LEP-PEA-EPUSP/OpenSourcePowerElectronics-HW-LoadBoard-2026/README.md

# OpenSourcePowerElectronics-HW-LoadBoard-2026

This repository contains the manuals, schematics, layouts and other files necessary to build and used the AC and DC load boards.
