LEP-PEA-EPUSP/OpenSourcePowerElectronics-HW-LoadBoard-2026/Schematics and Layout/AC Load/Esquemático.PNG

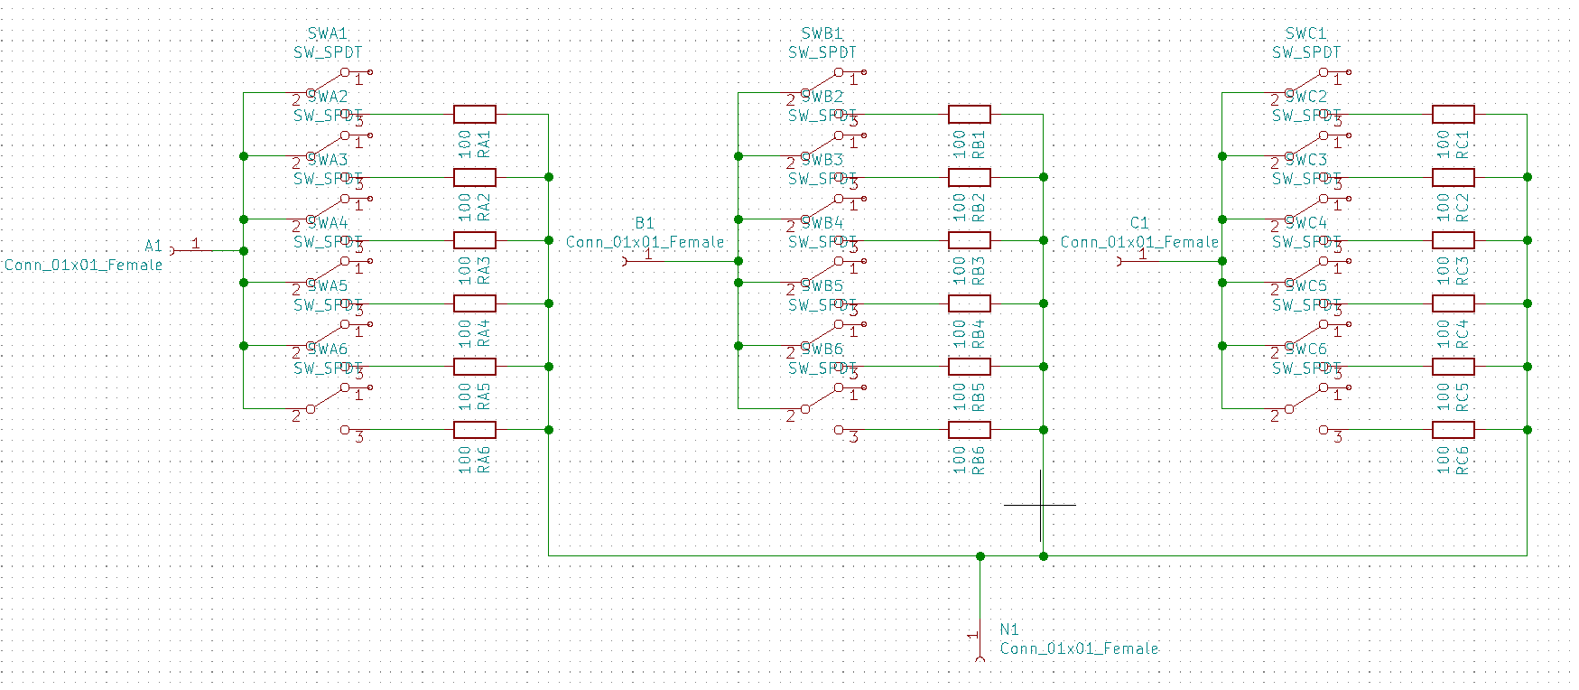
Schematics and Layout/AC Load/Esquemático.PNG
