LEP-PEA-EPUSP/OpenSourcePowerElectronics-HW-LoadBoard-2026/Schematics and Layout/DC Load/Esquemático_CC.PNG

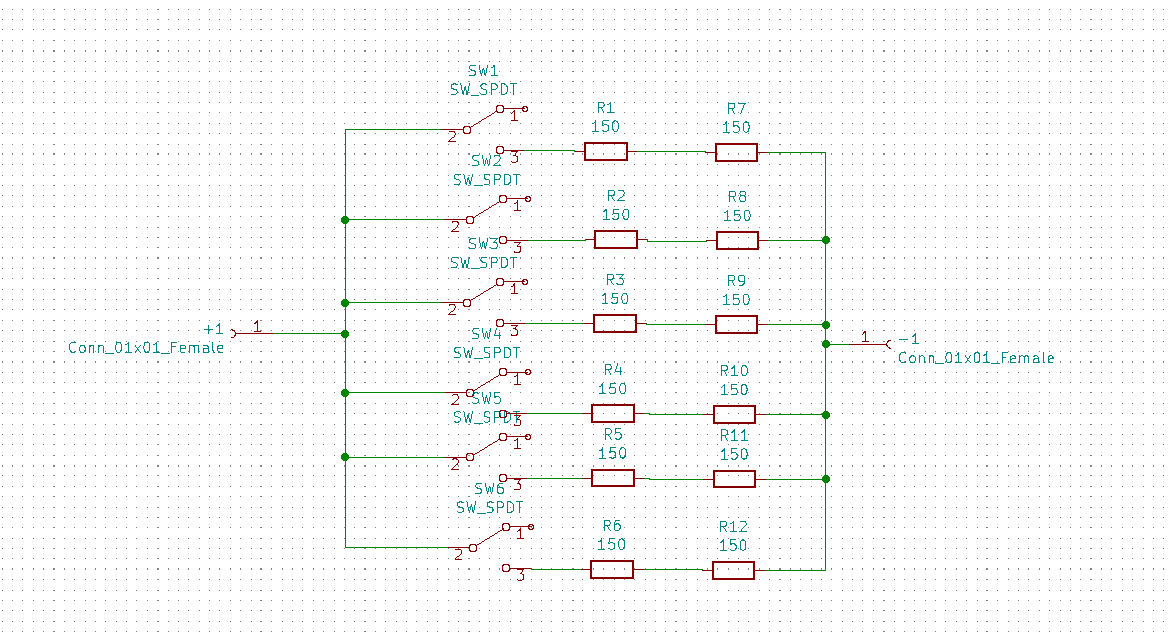
Schematics and Layout/DC Load/Esquemático_CC.PNG
