LEP-PEA-EPUSP/OpenSourcePowerElectronics-HW-LoadBoard-2026/Schematics and Layout/DC Load/Proposta CC.png

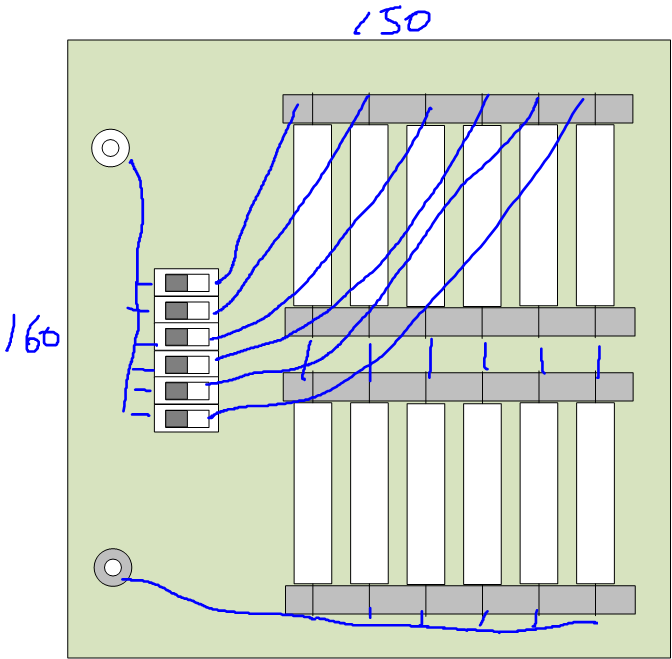
Schematics and Layout/DC Load/Proposta CC.png
