LEP-PEA-EPUSP/OpenSourcePowerElectronics-HW-LoadBoard-2026/Schematics and Layout/AC Load/placa de resistores CAx.pdf

Placa cimenticia:
- espessura: 8mm
- altura proposta da barra: 16mm
- comprimento: a decidir

Resistor de 10W porcelana
- Comp=48mm
- Larg= 9,5mm
- altura=9,5
- terminal : comp=32mm;
diam=0,7mm

Chave HH
- ver detalhes dos terminais
- soldar pinos da carcaça

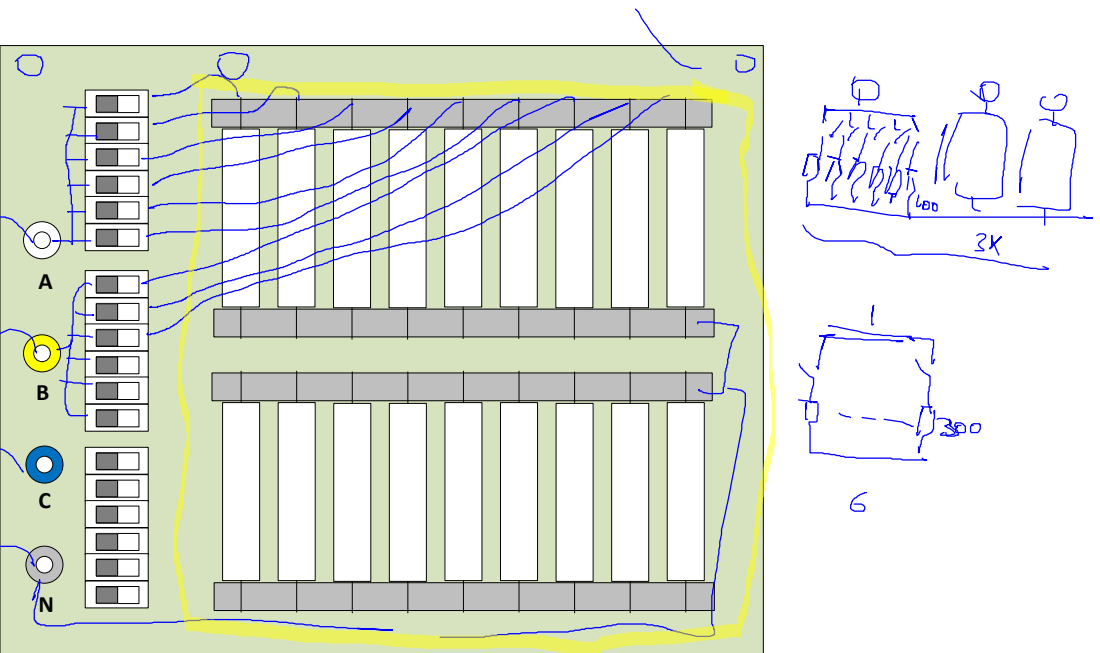
[picture p19: page 2]
ABCN

N | N | N

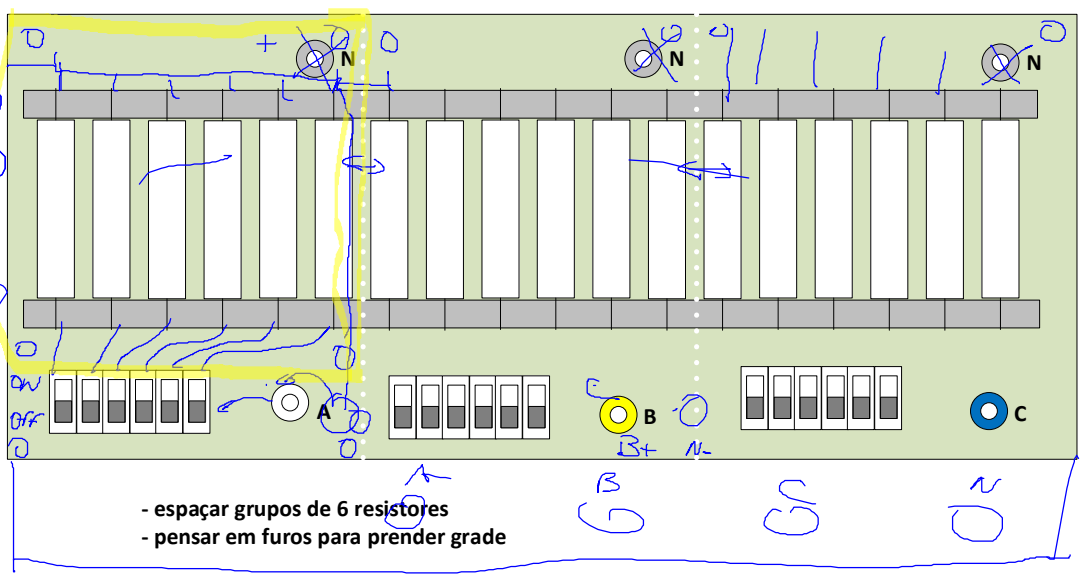
[picture p20: page 3]

- espaçar grupos de 6 resistores
- pensar em furos para prender grade
