LEP-PEA-EPUSP/OpenSourcePowerElectronics-HW-LoadBoard-2026/Schematics and Layout/AC Load/camadas separadas.pdf

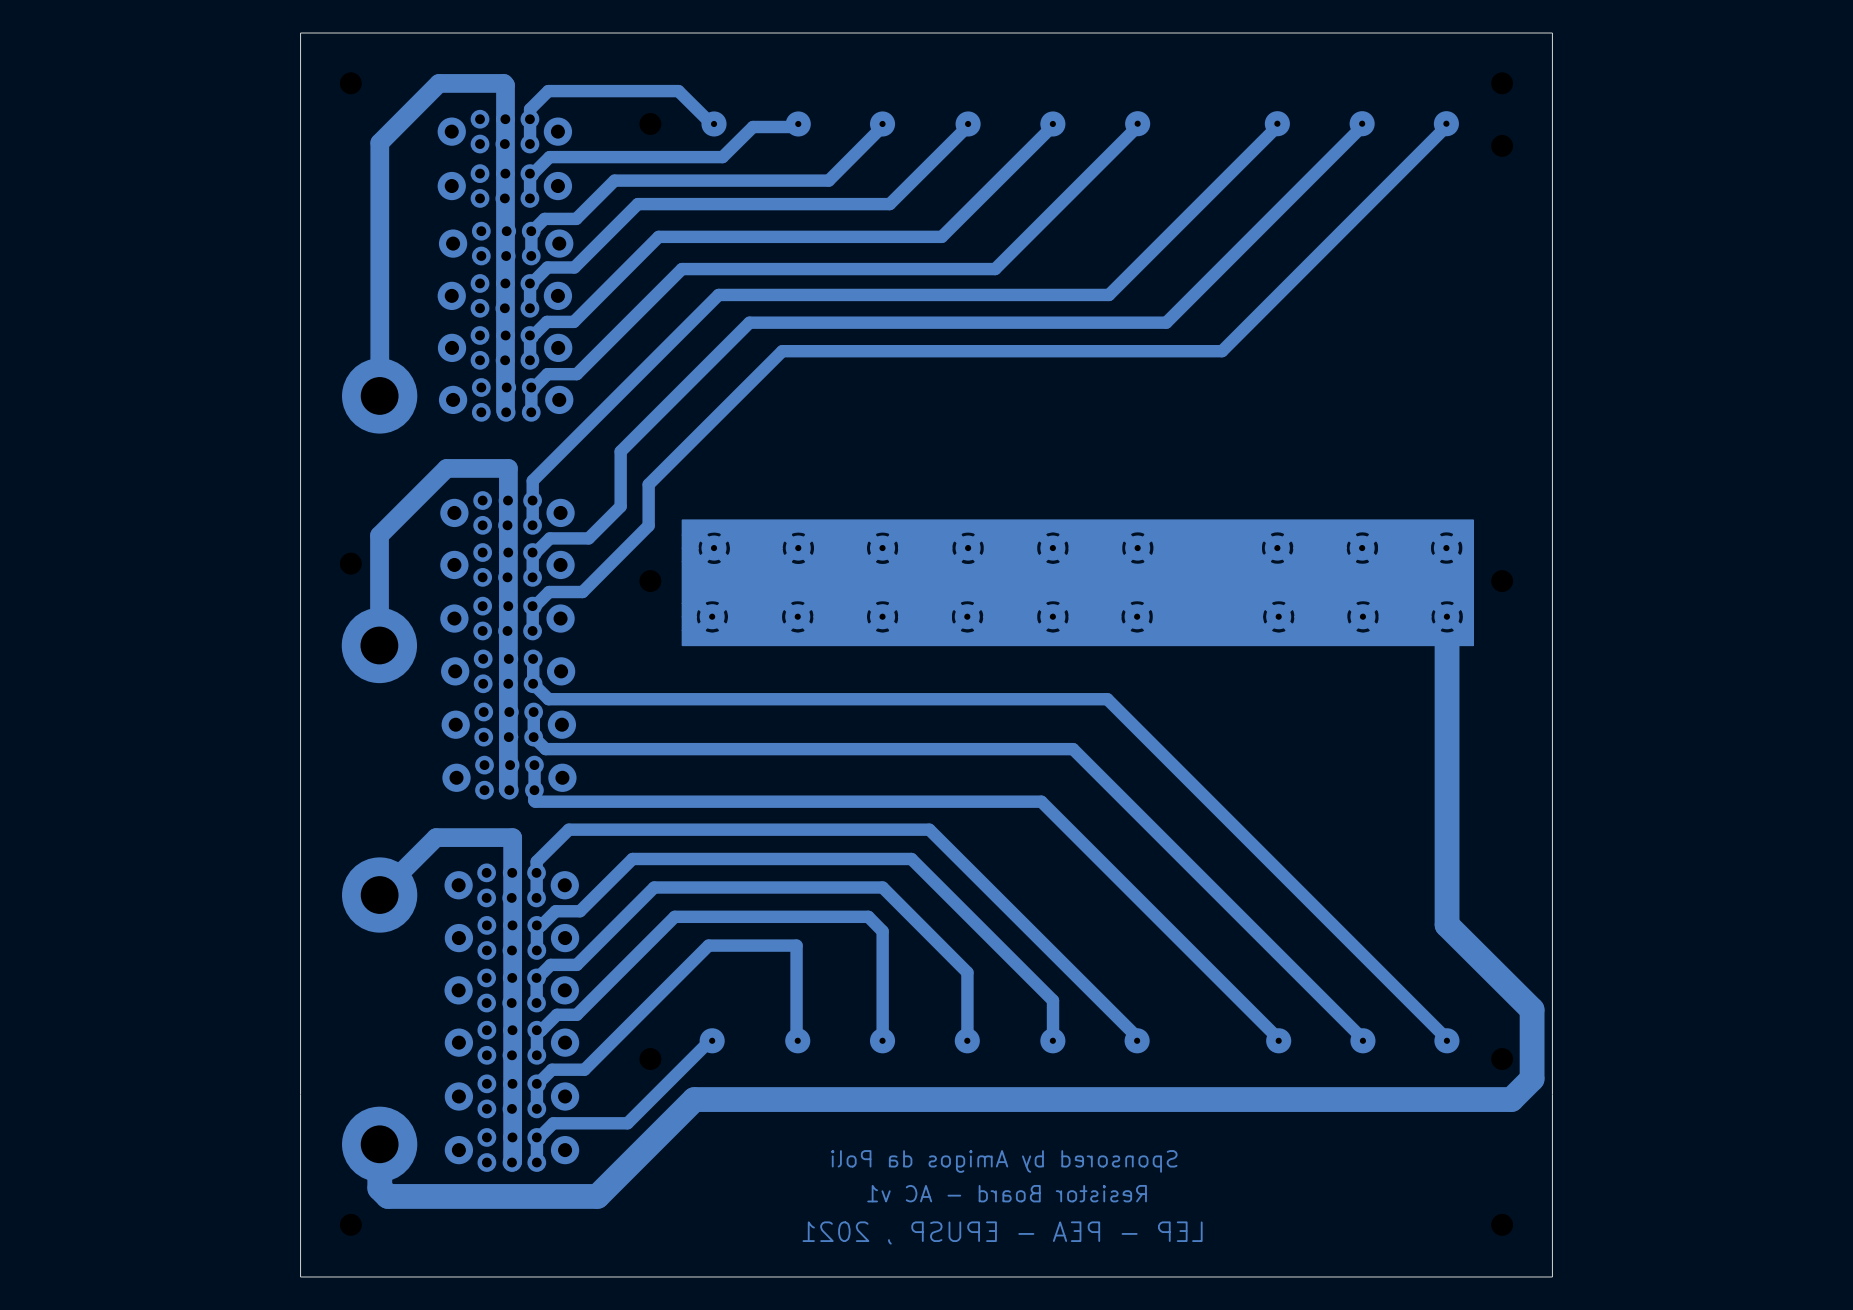
[picture p21: page 1]

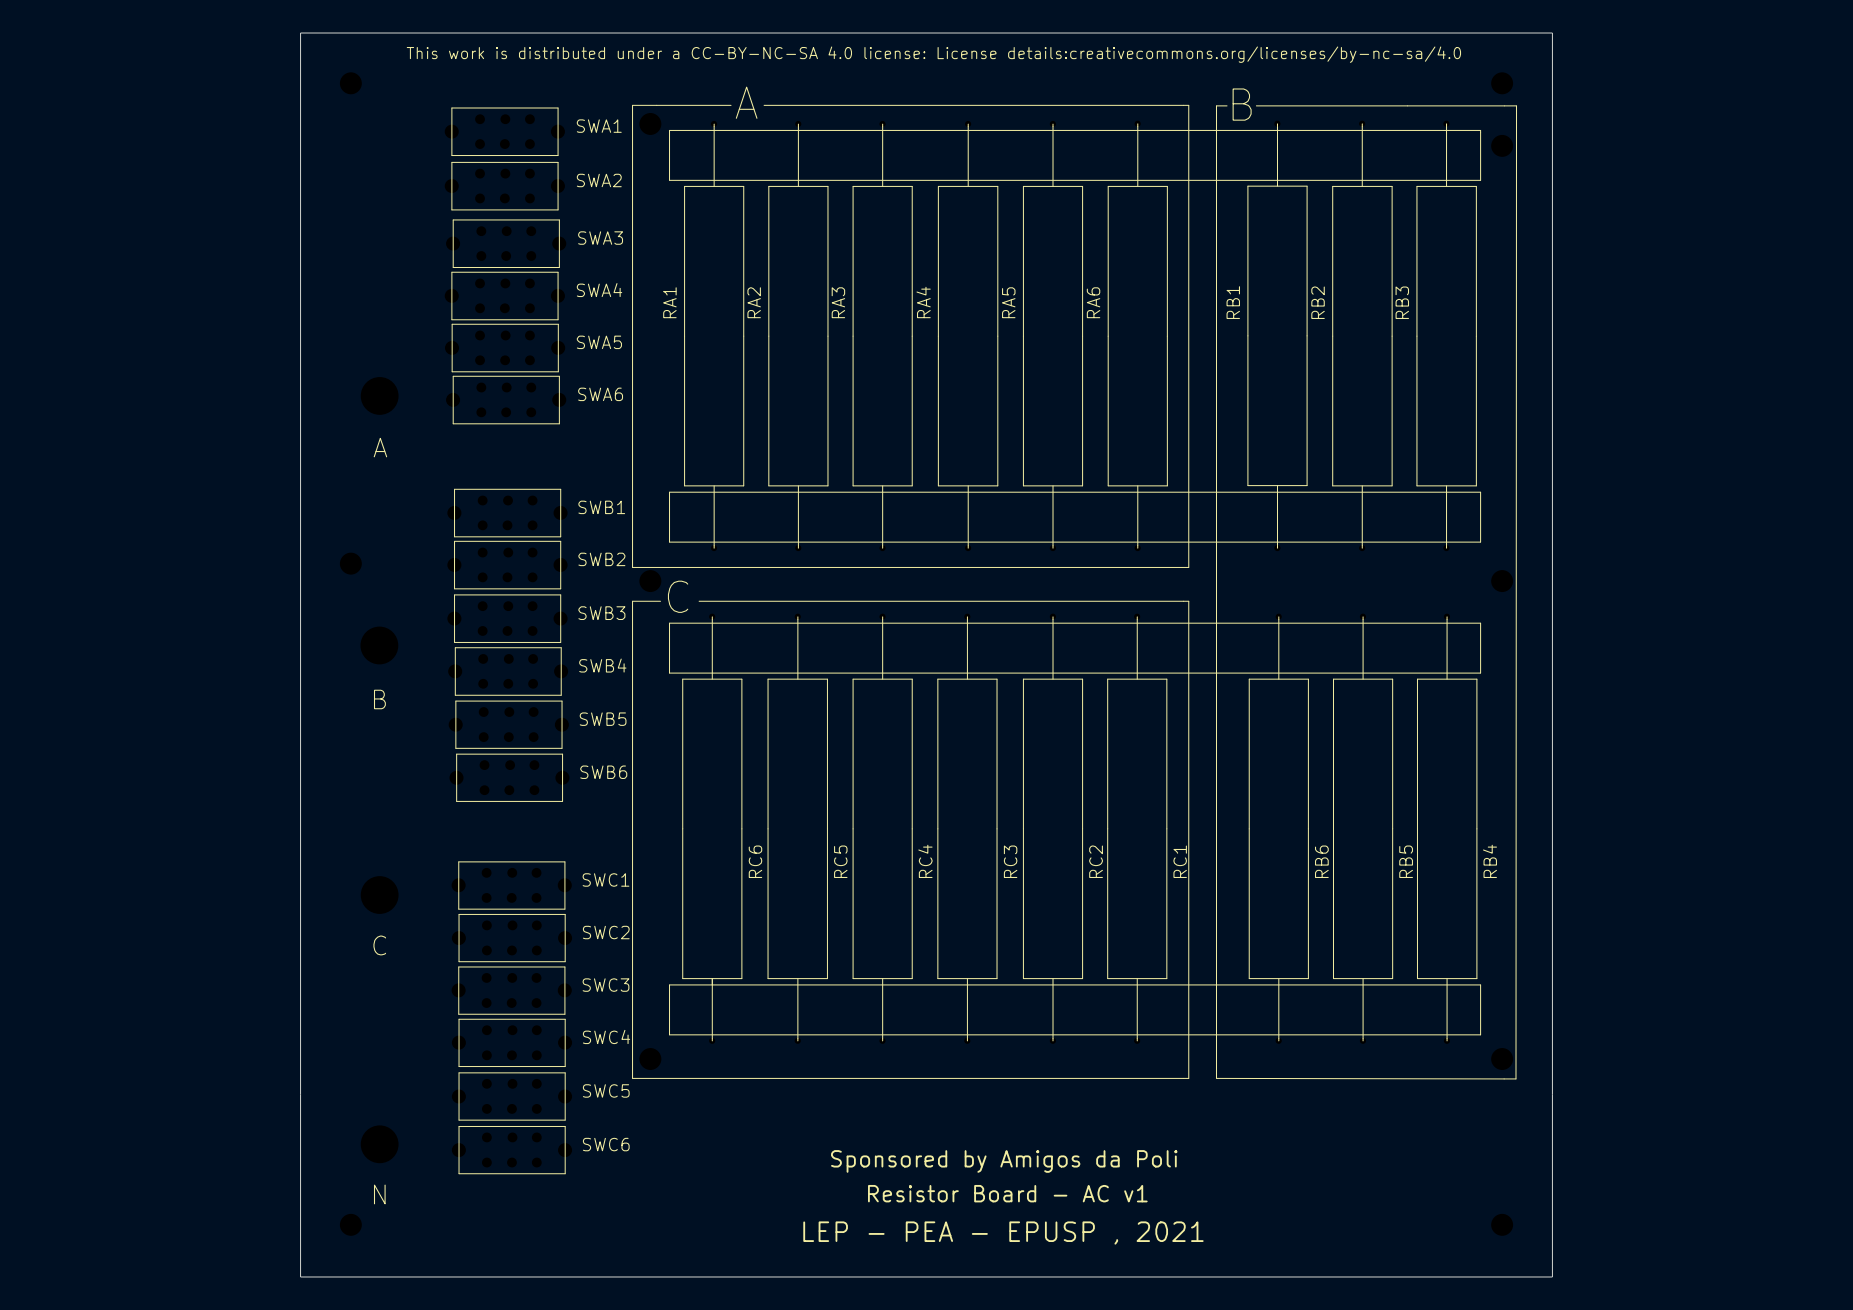
[picture p22: page 2]

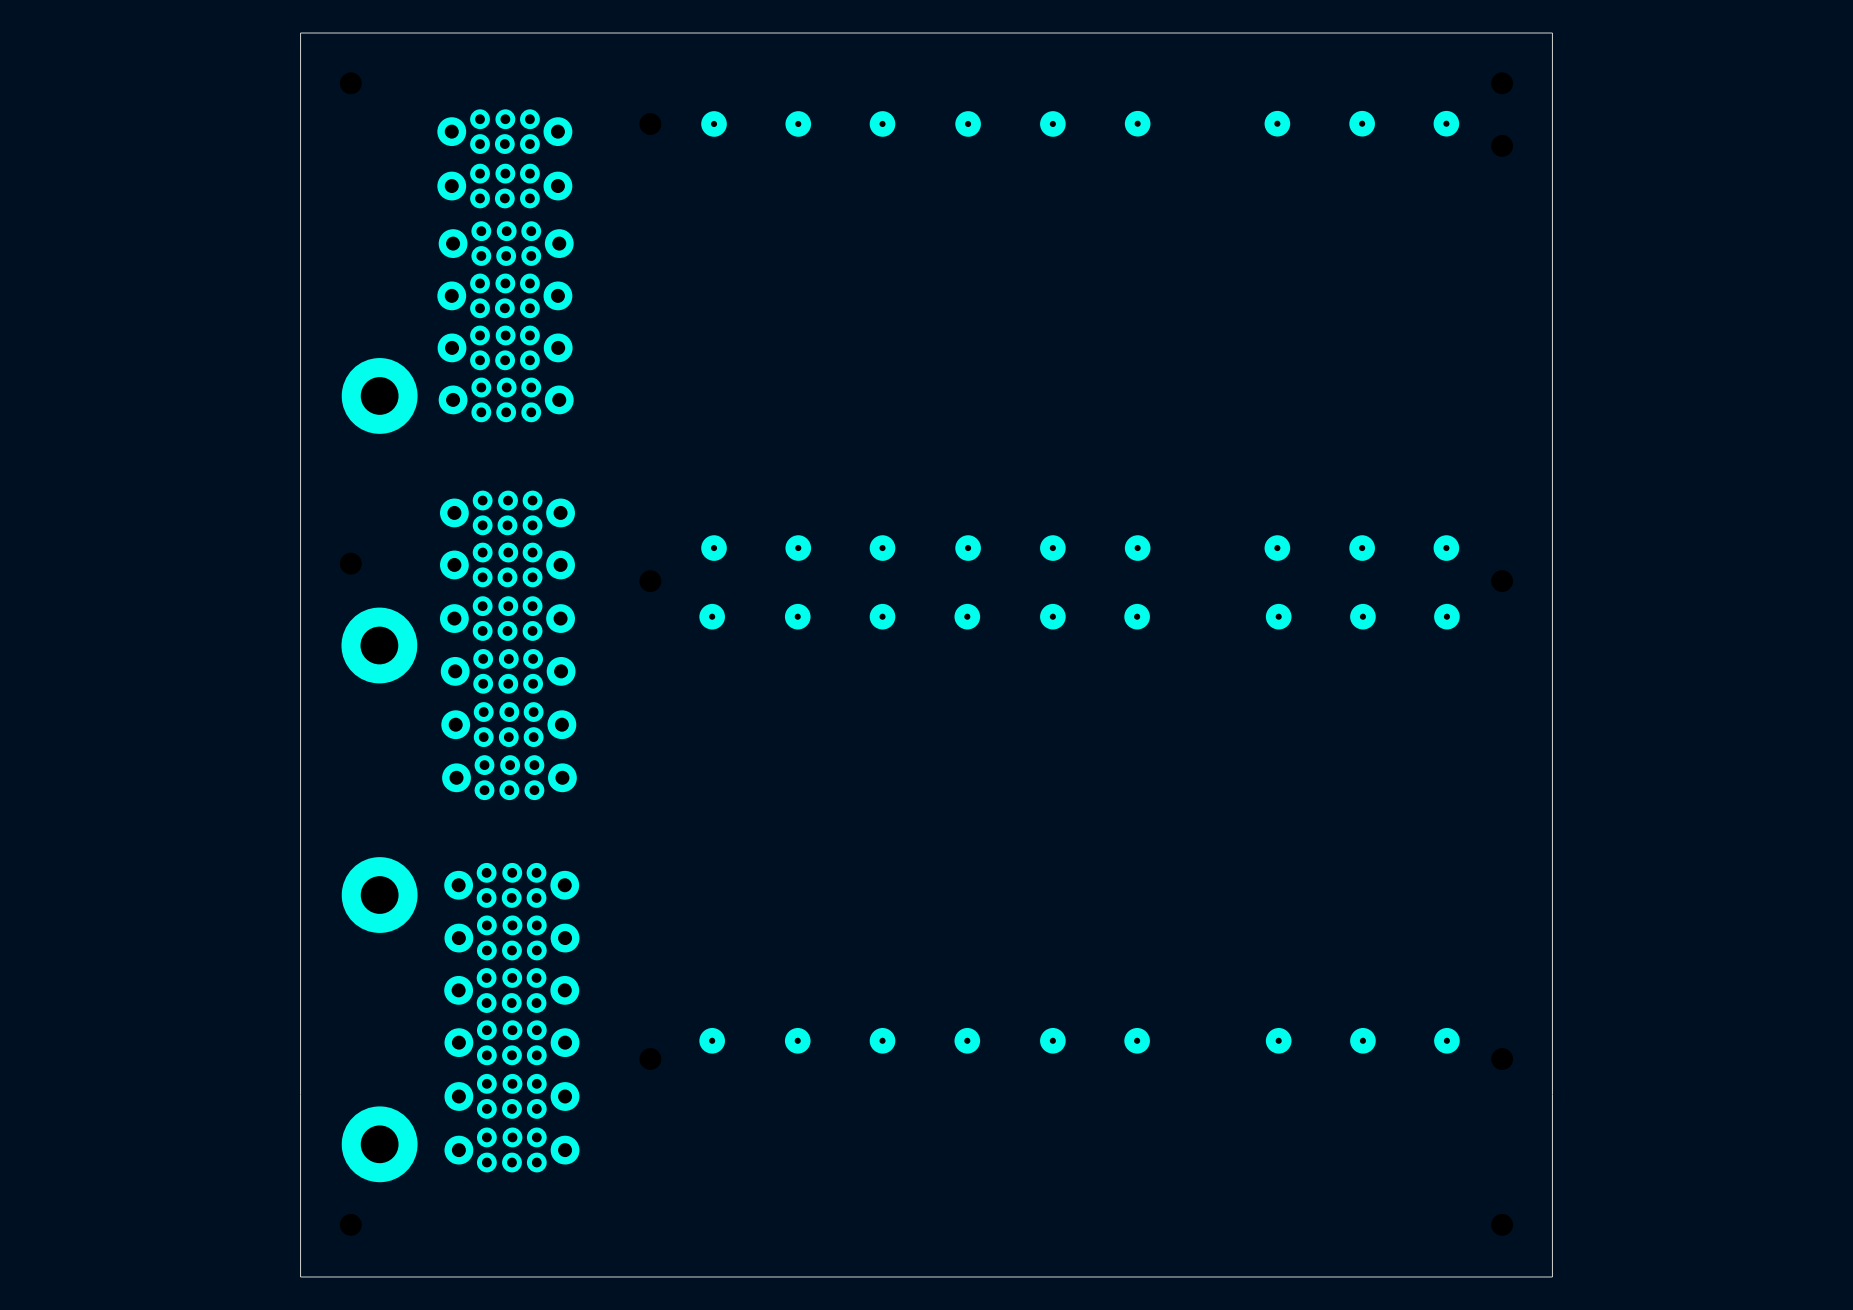
[picture p23: page 3]

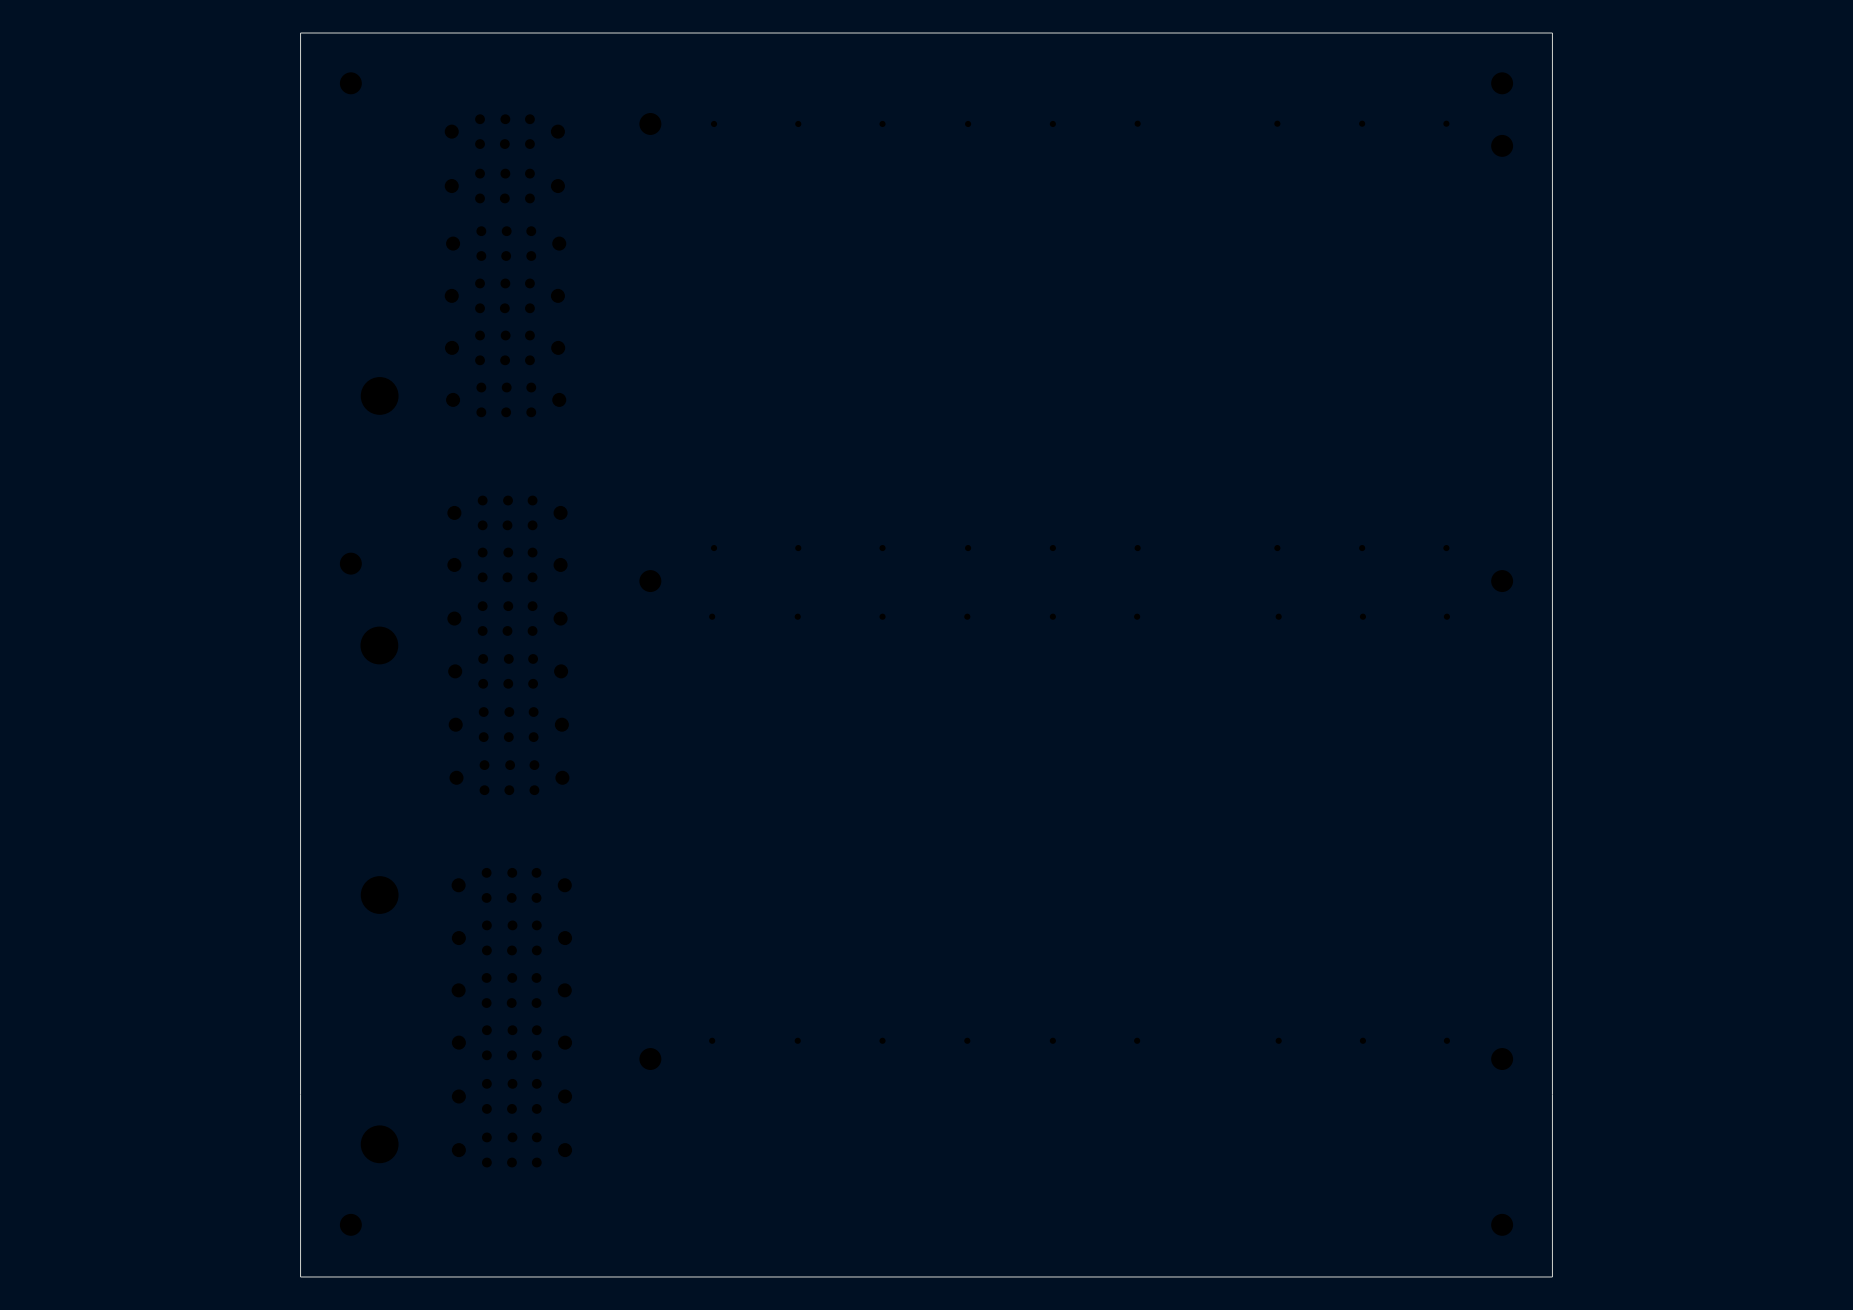
[picture p24: page 4]
