LEP-PEA-EPUSP/OpenSourcePowerElectronics-HW-LoadBoard-2026/Schematics and Layout/AC Load/esquemático.pdf

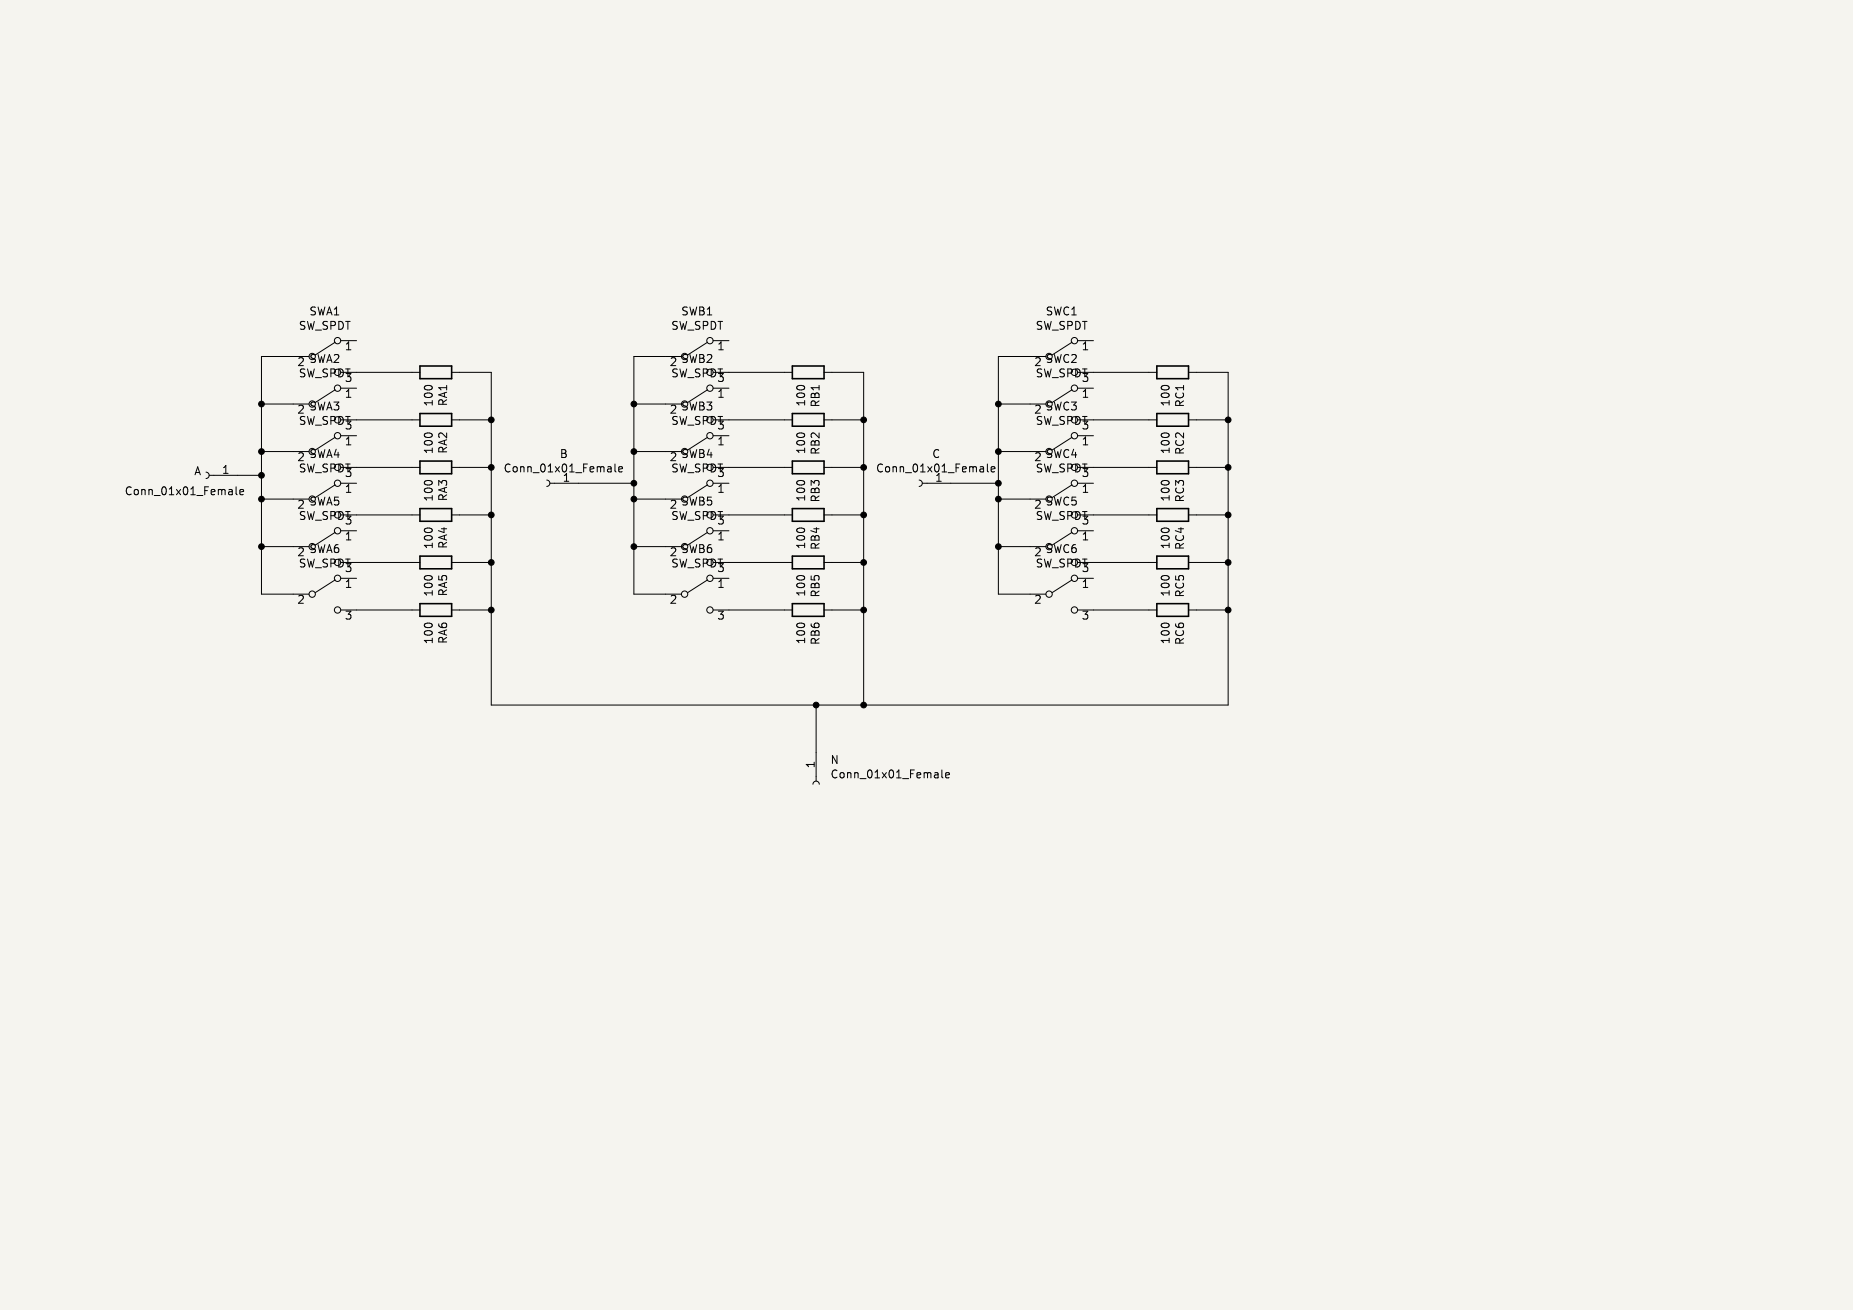
[picture p25: page 1]
