LEP-PEA-EPUSP/OpenSourcePowerElectronics-HW-LoadBoard-2026/Schematics and Layout/AC Load/layout_CA.pdf

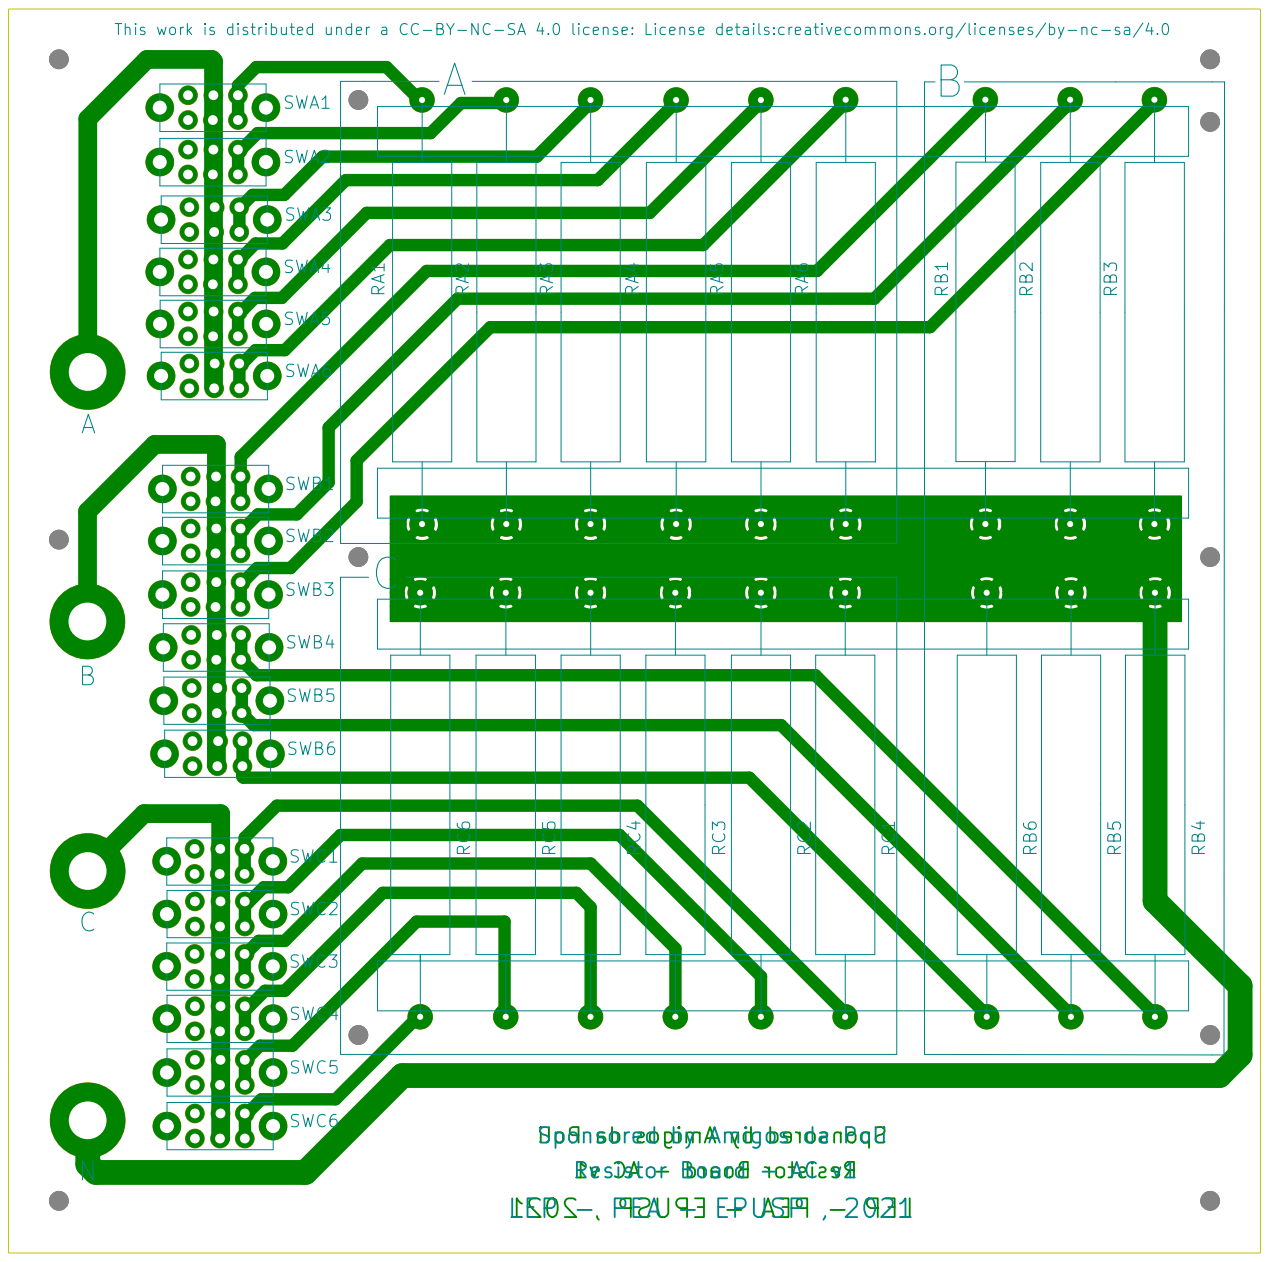
[picture p26: page 1]
