LEP-PEA-EPUSP/OpenSourcePowerElectronics-HW-LoadBoard-2026/Schematics and Layout/DC Load/CC_camadas_juntas.pdf

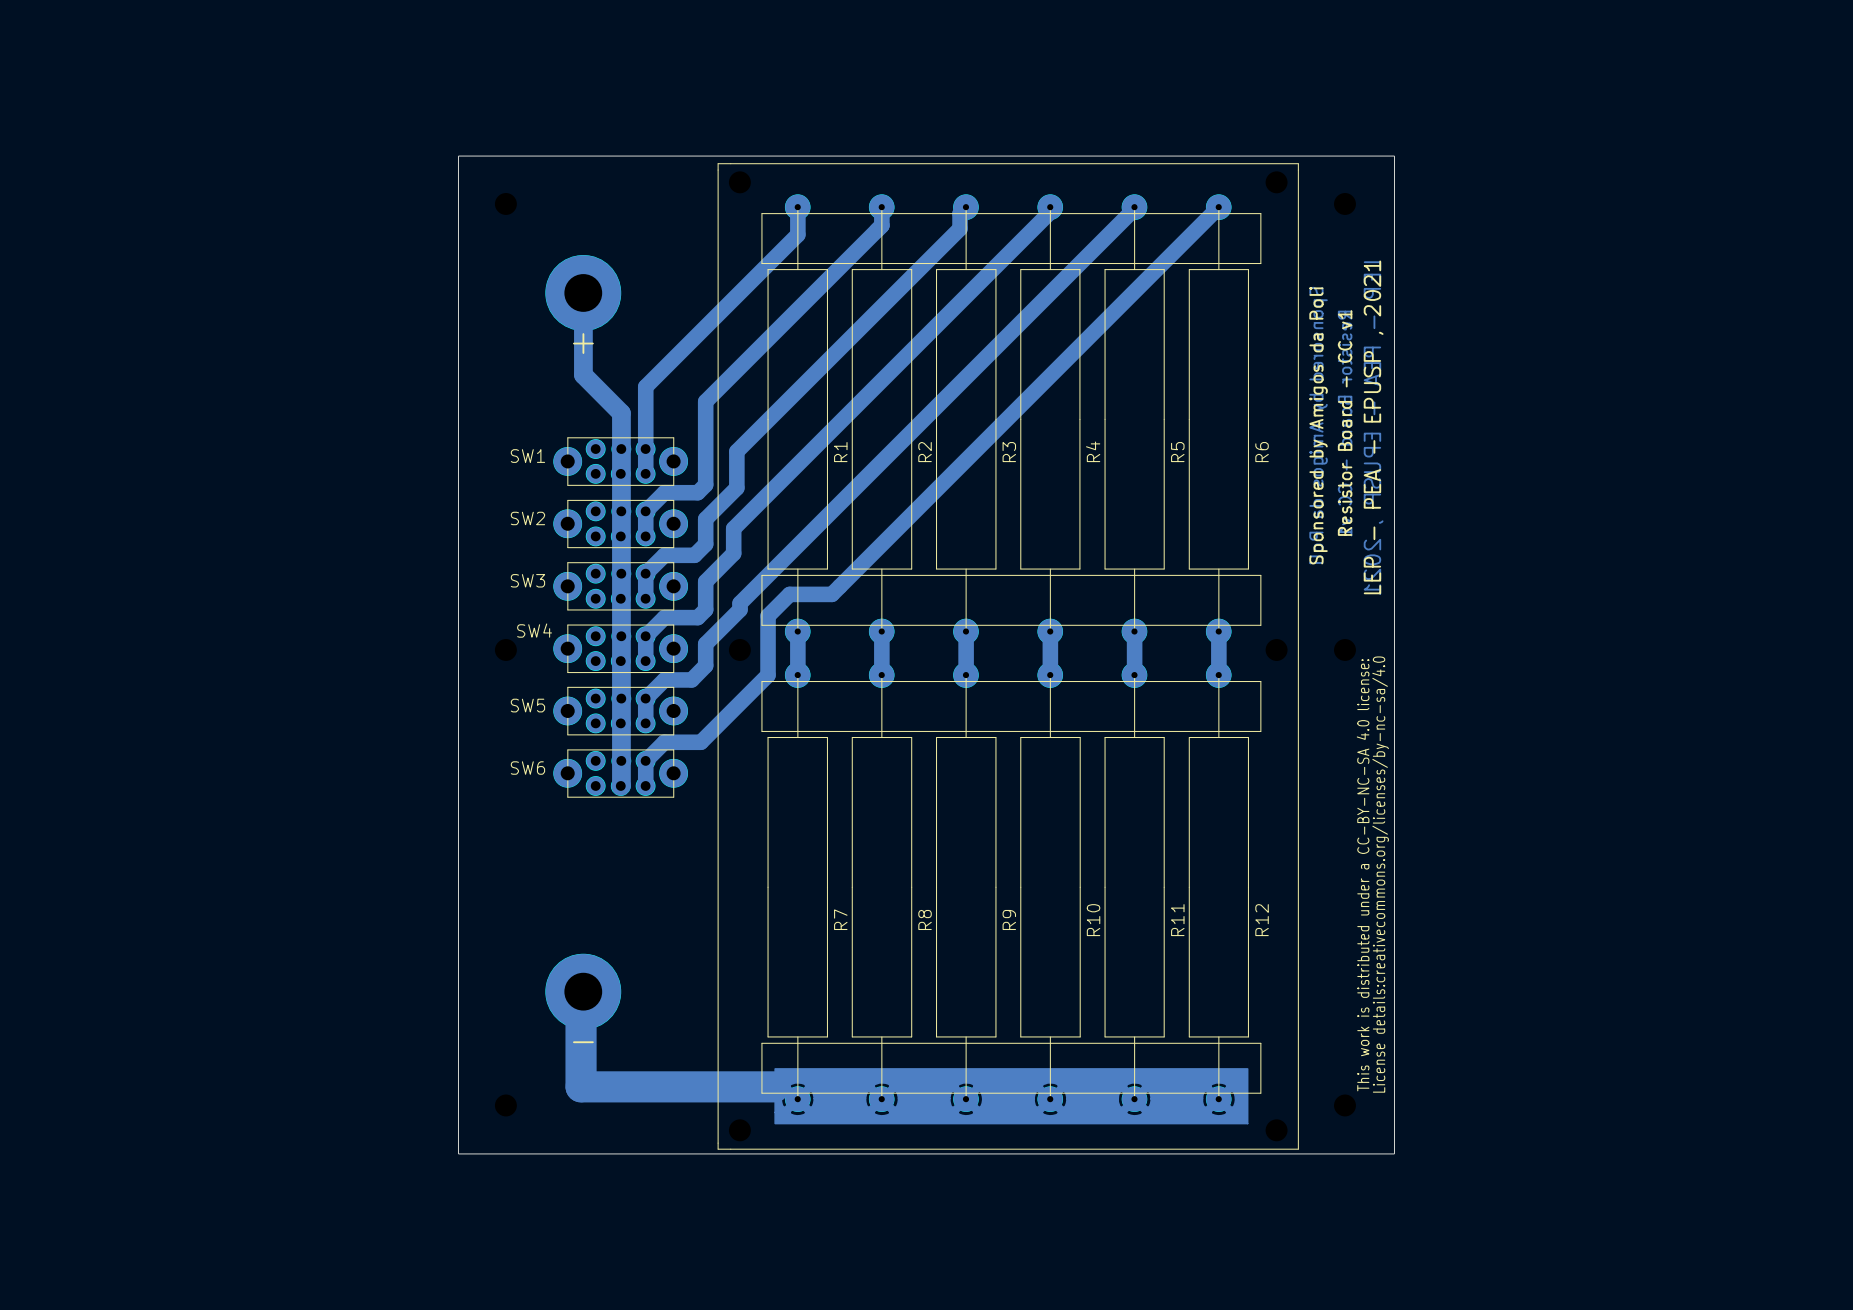
[picture p29: page 1]
