LEP-PEA-EPUSP/OpenSourcePowerElectronics-HW-LoadBoard-2026/Schematics and Layout/DC Load/CC_camadas_separadas.pdf

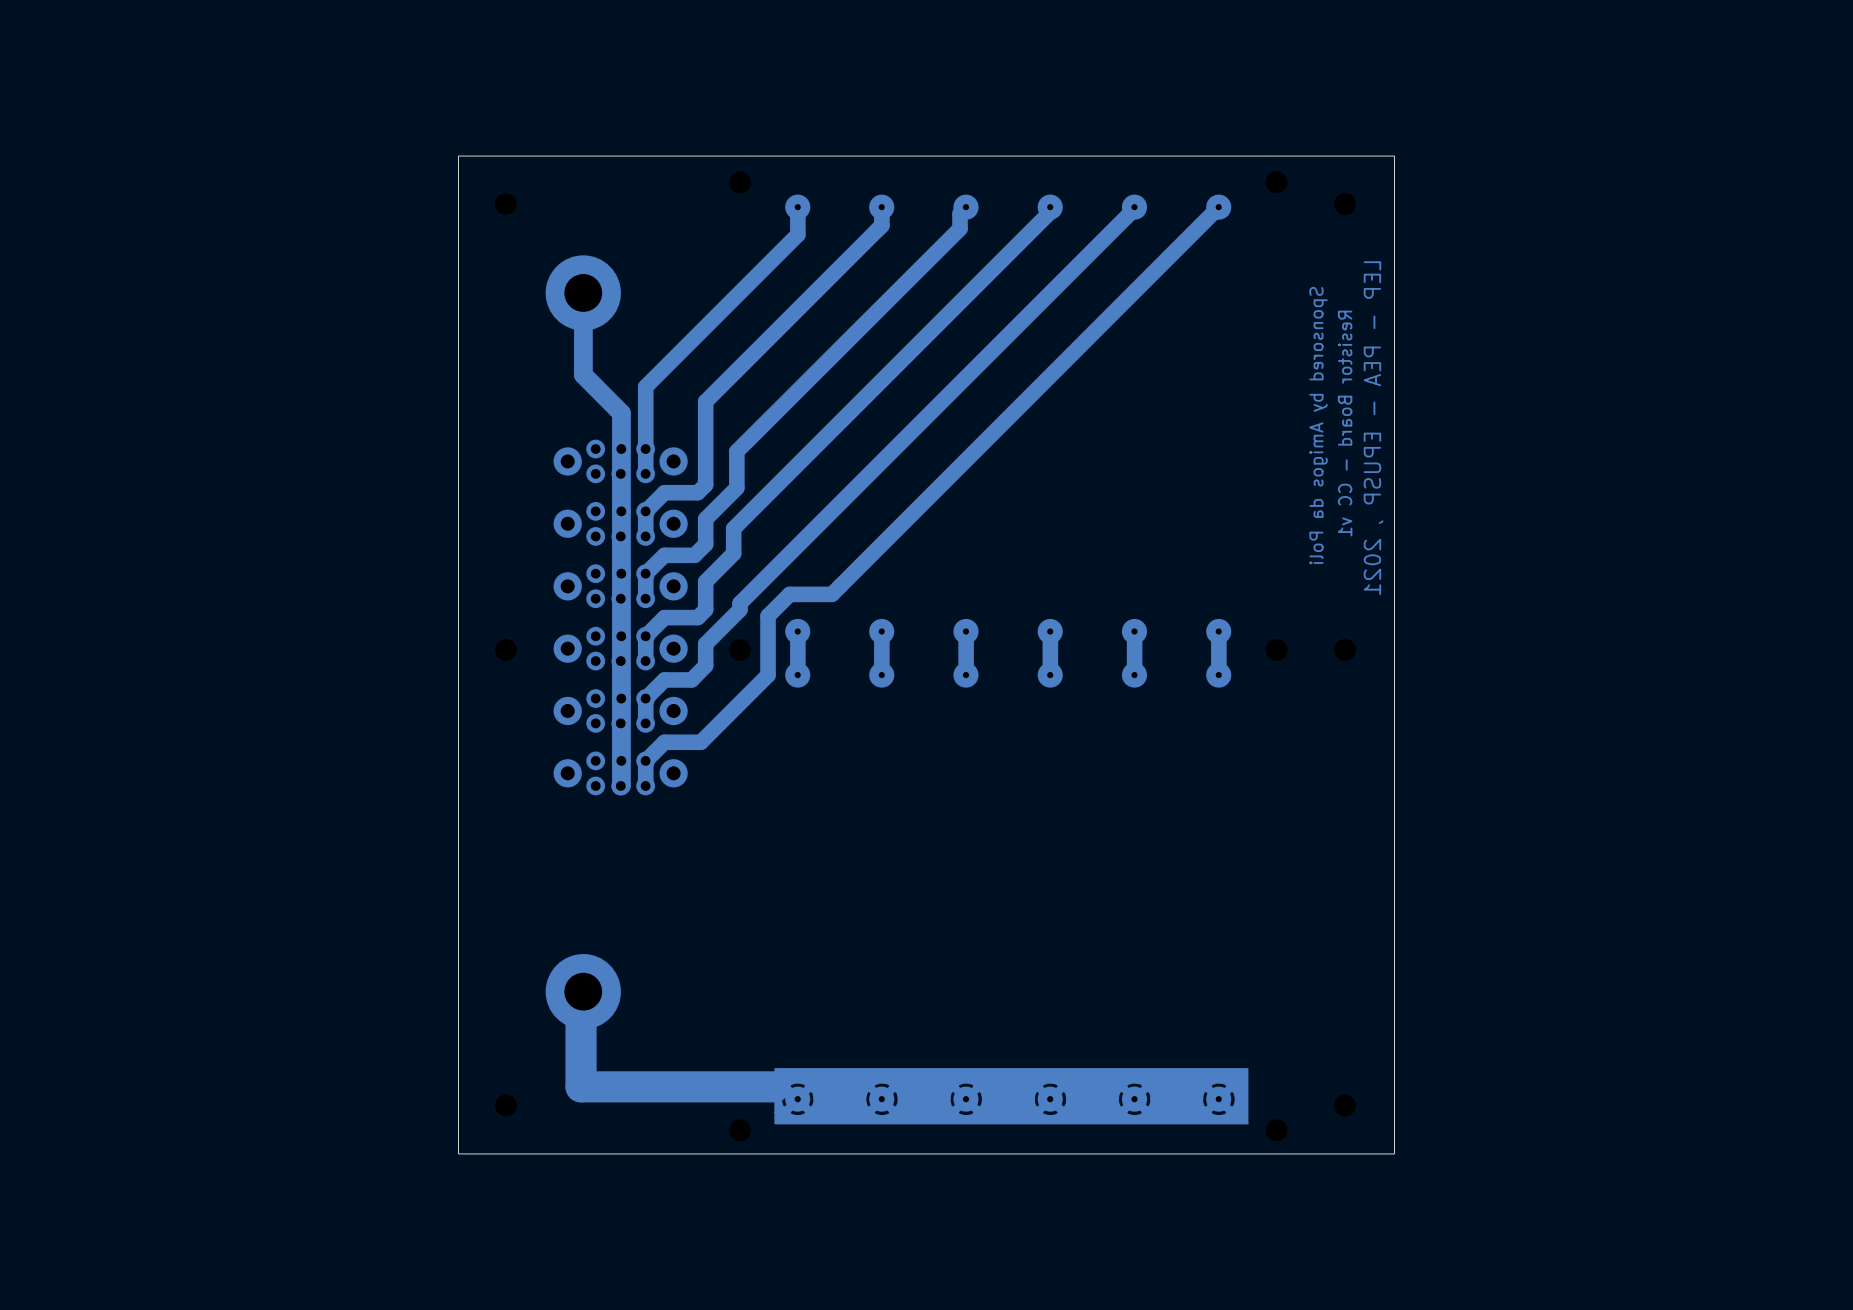
[picture p30: page 1]

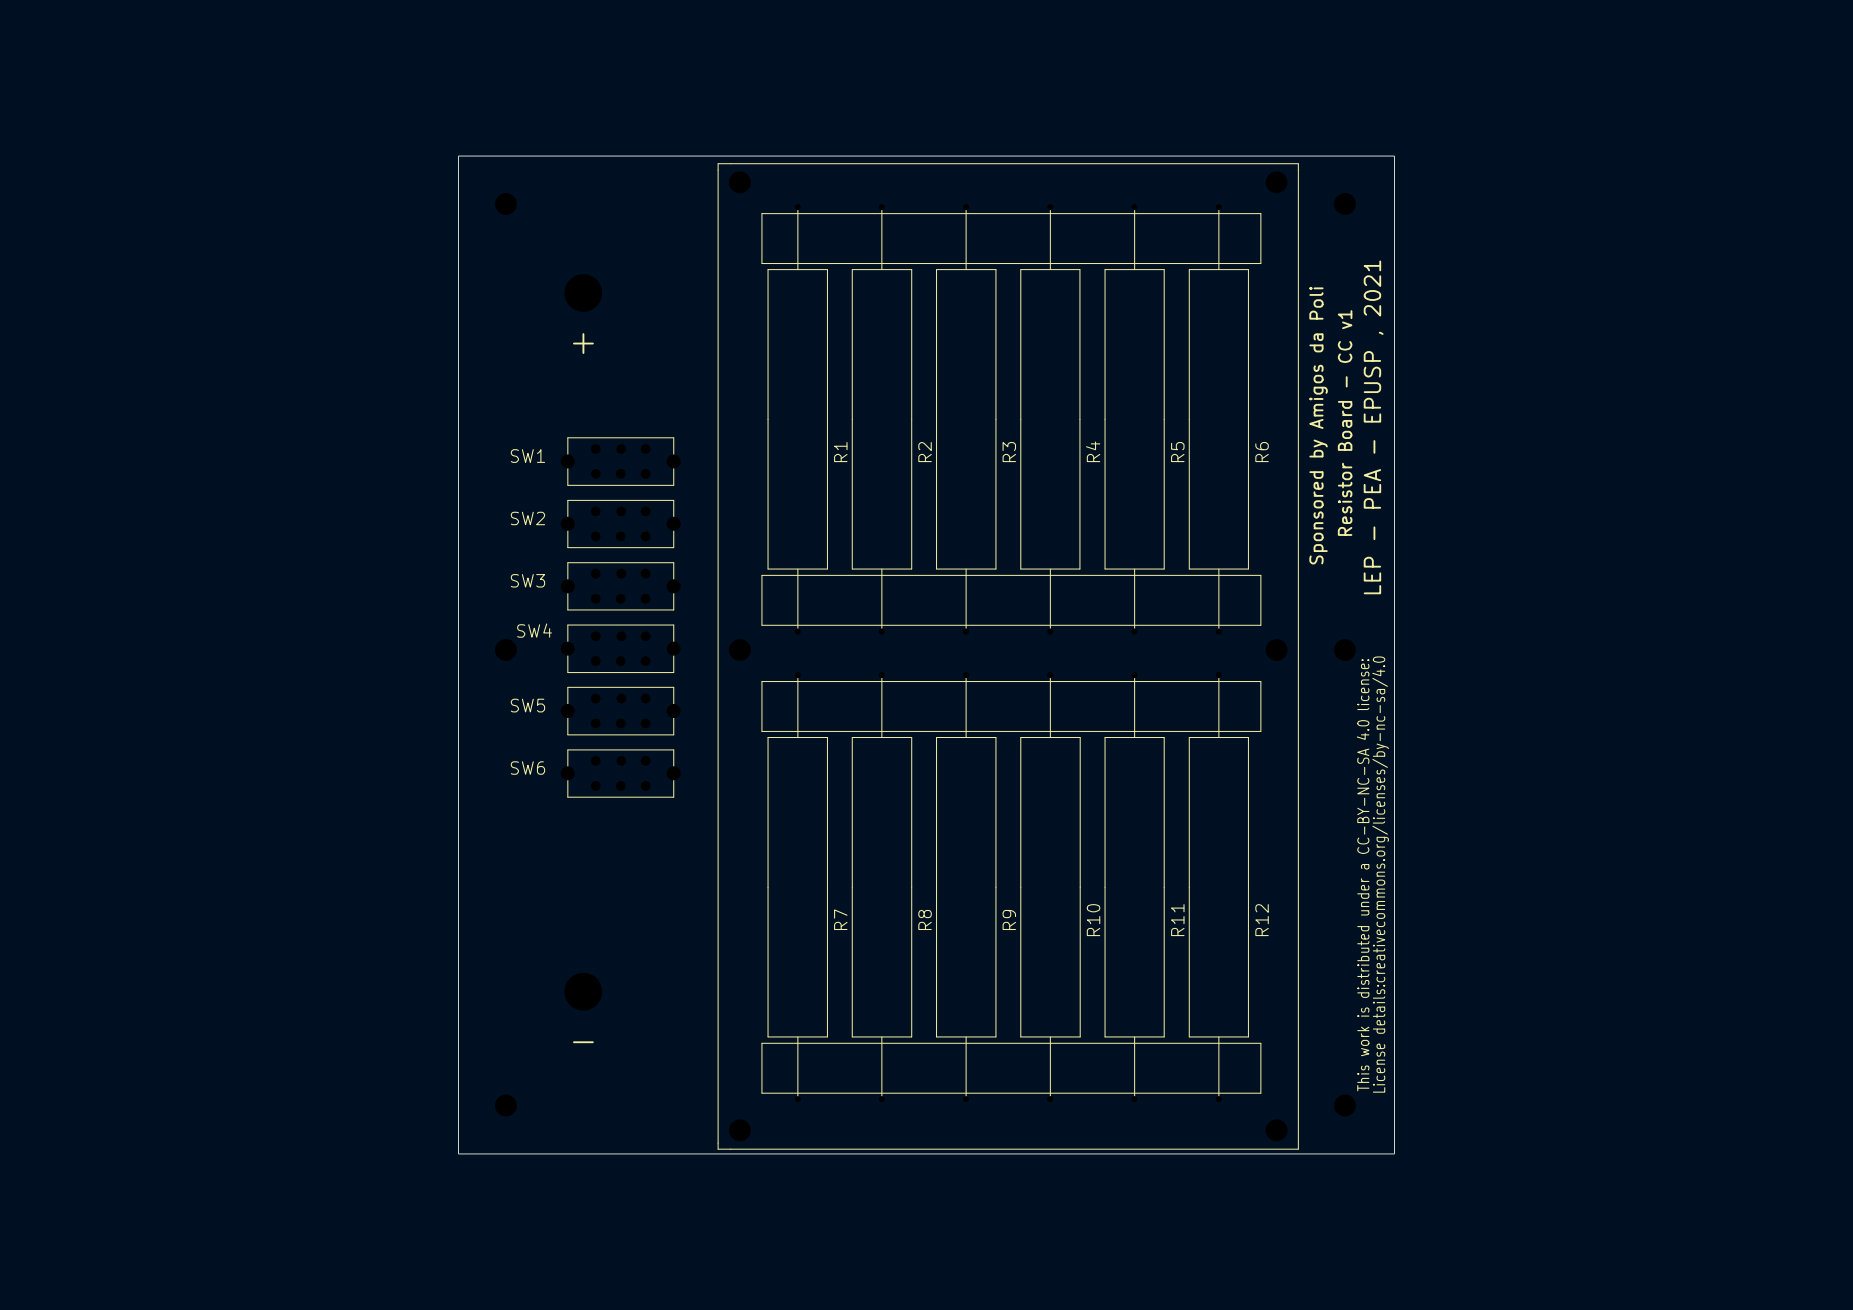
[picture p31: page 2]

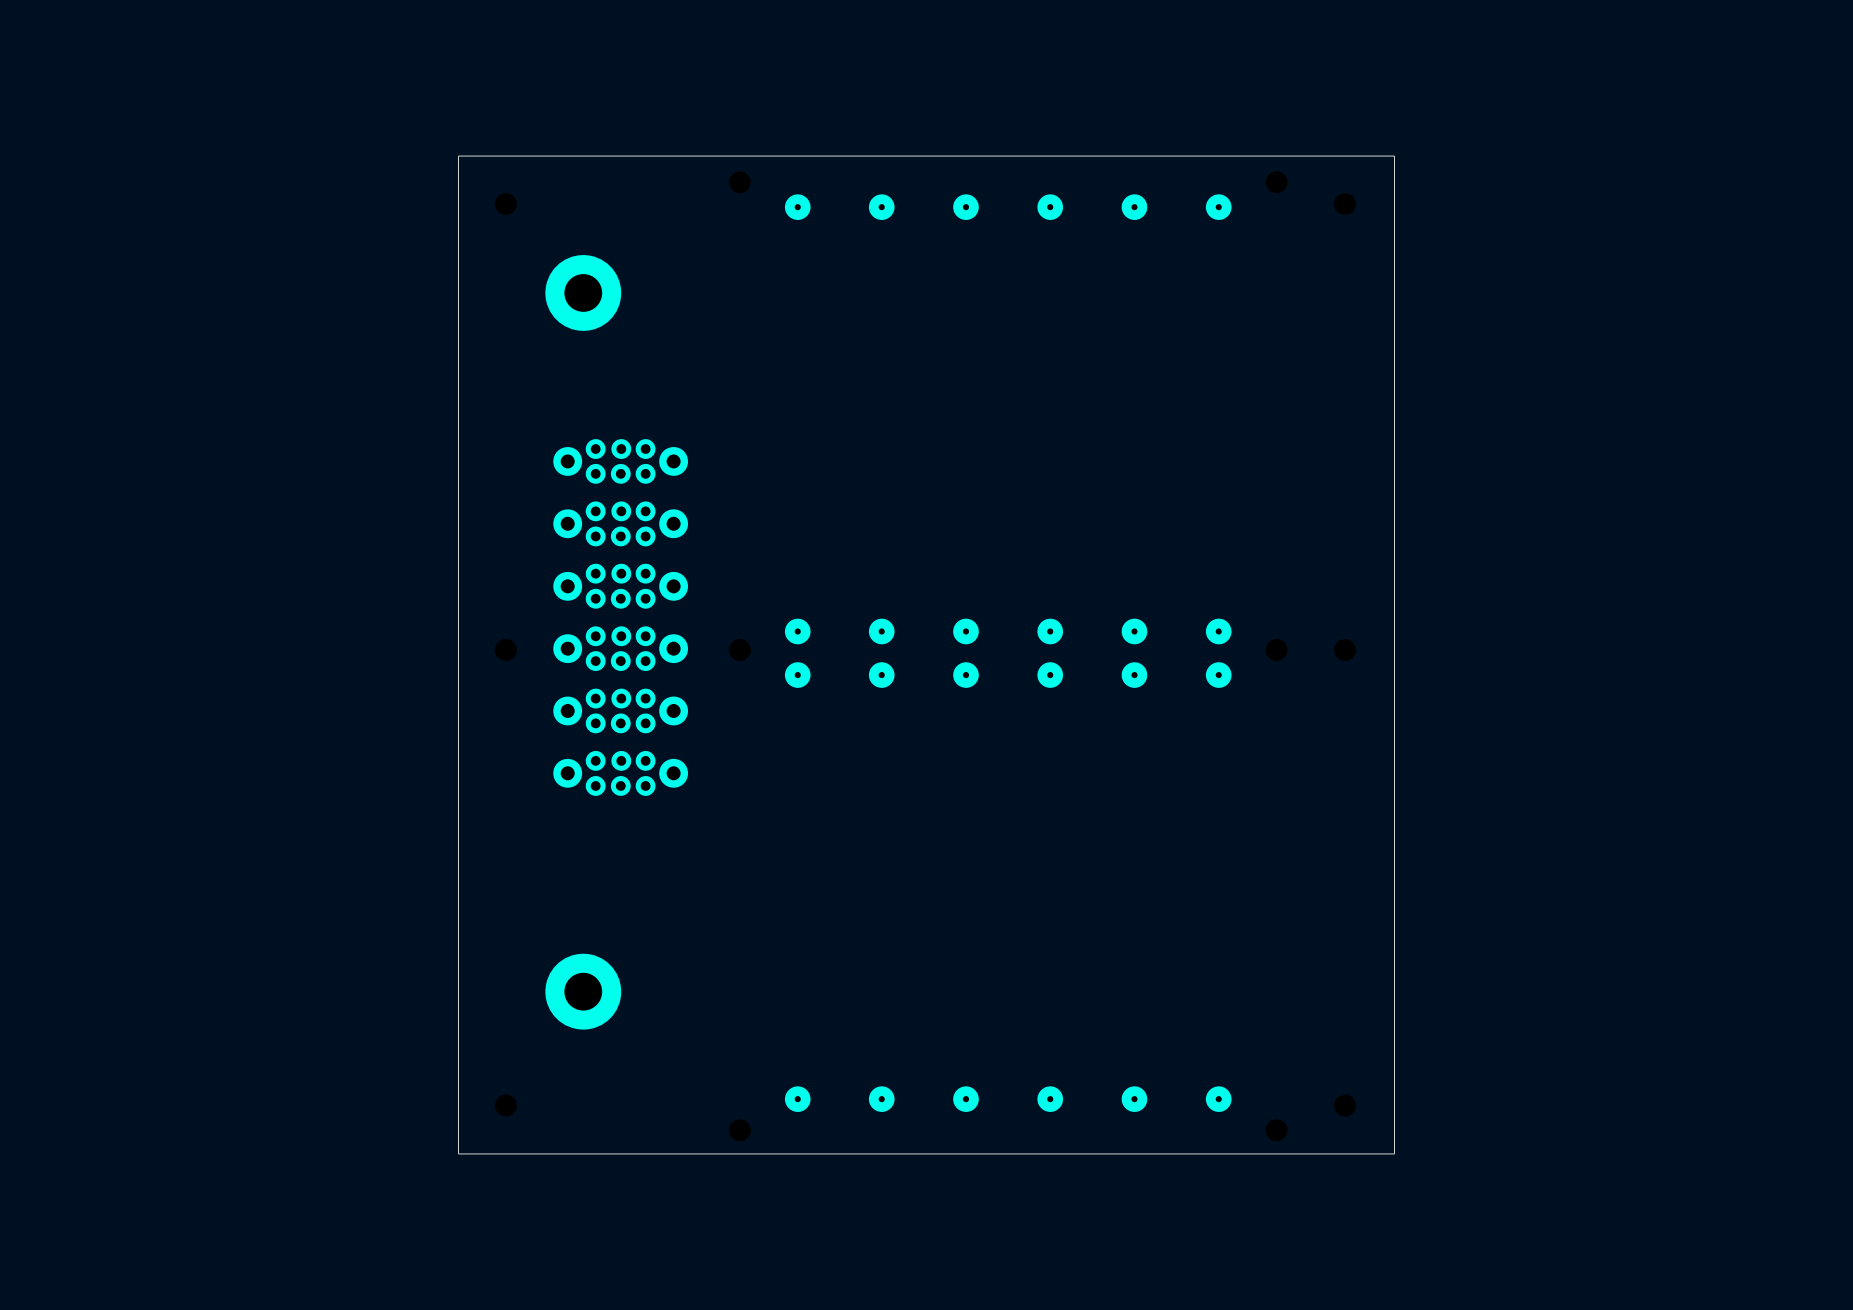
[picture p32: page 3]

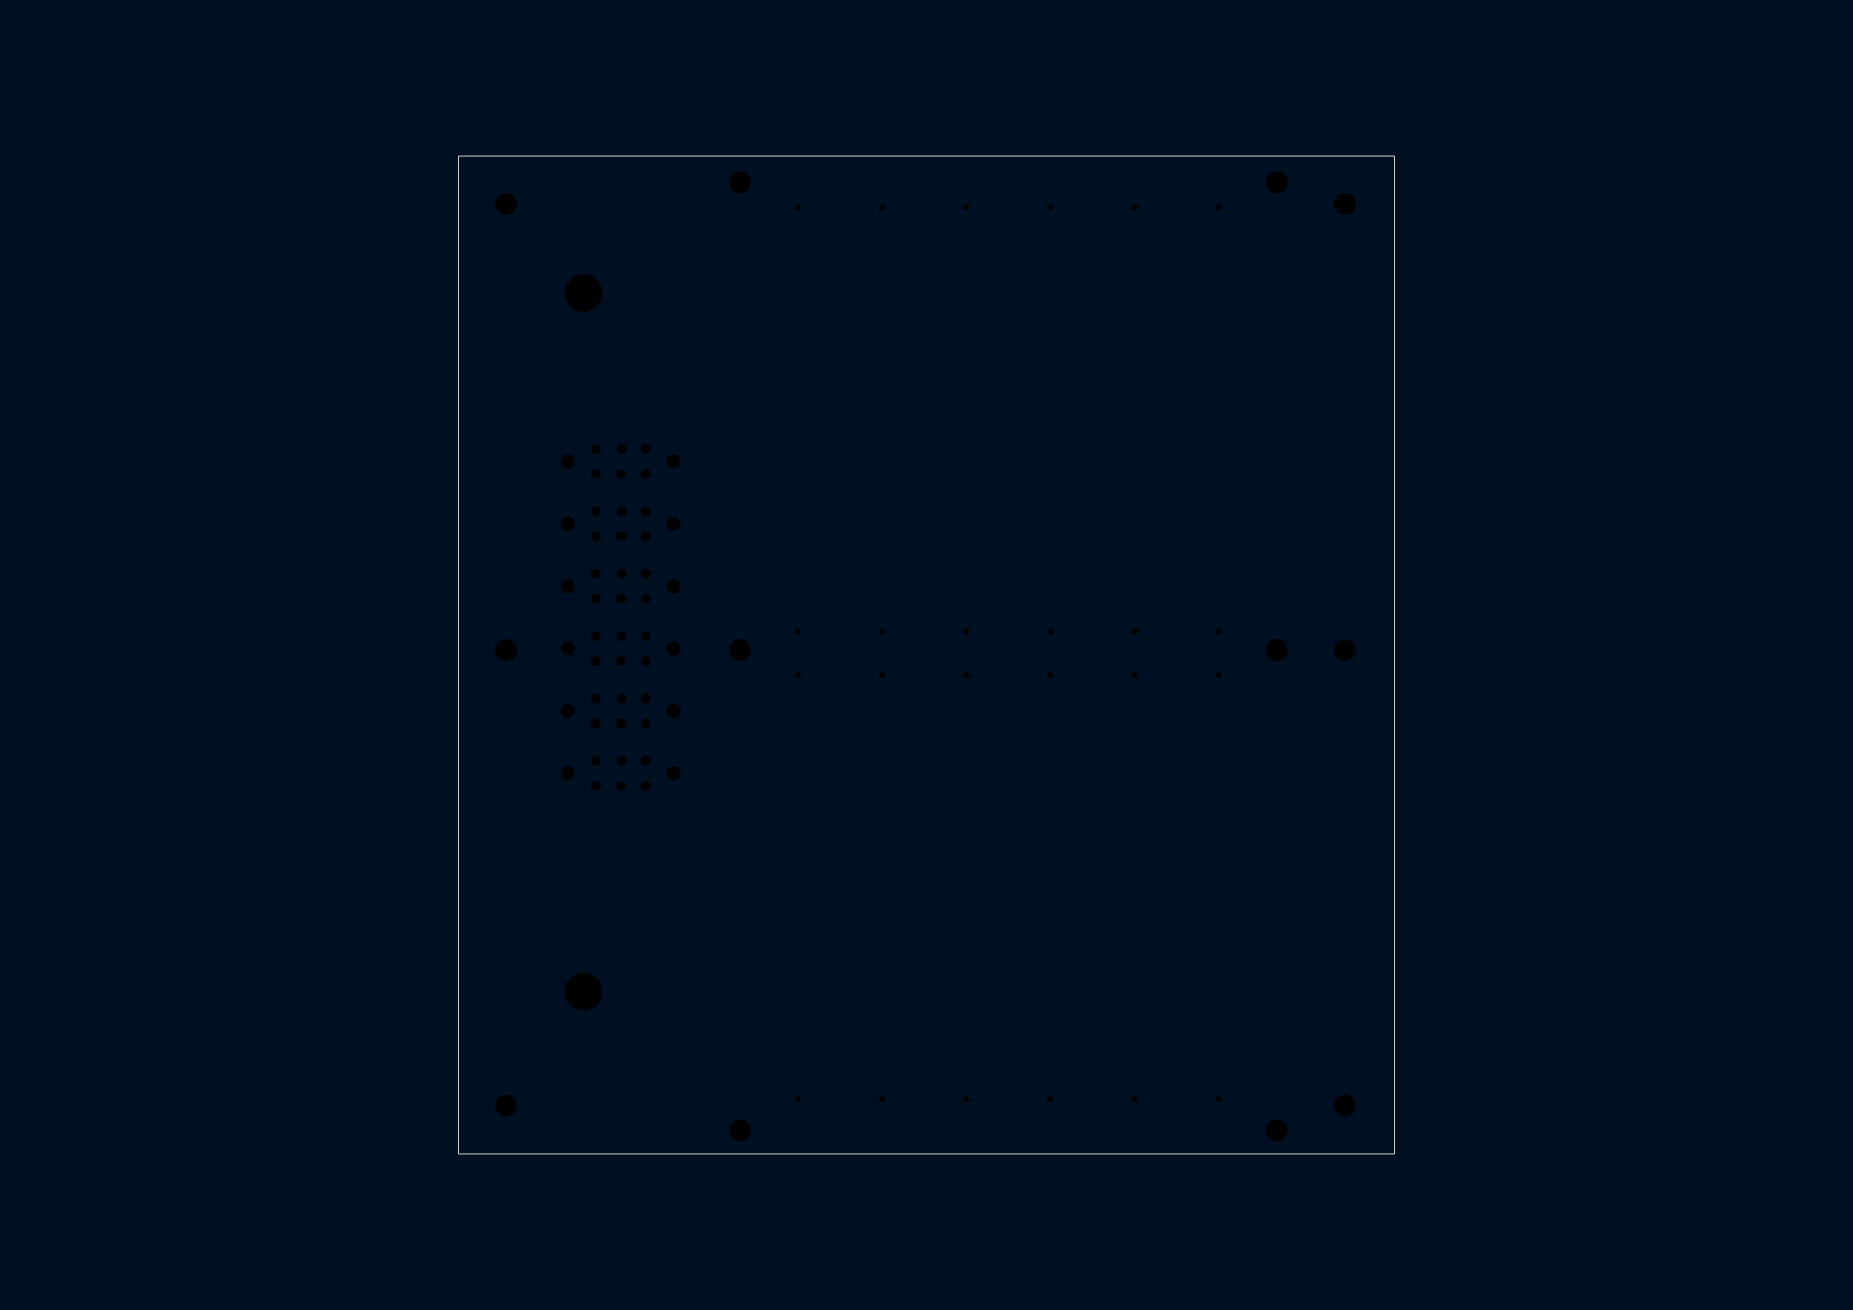
[picture p33: page 4]
