LEP-PEA-EPUSP/OpenSourcePowerElectronics-HW-LoadBoard-2026/Schematics and Layout/DC Load/esquemático.pdf

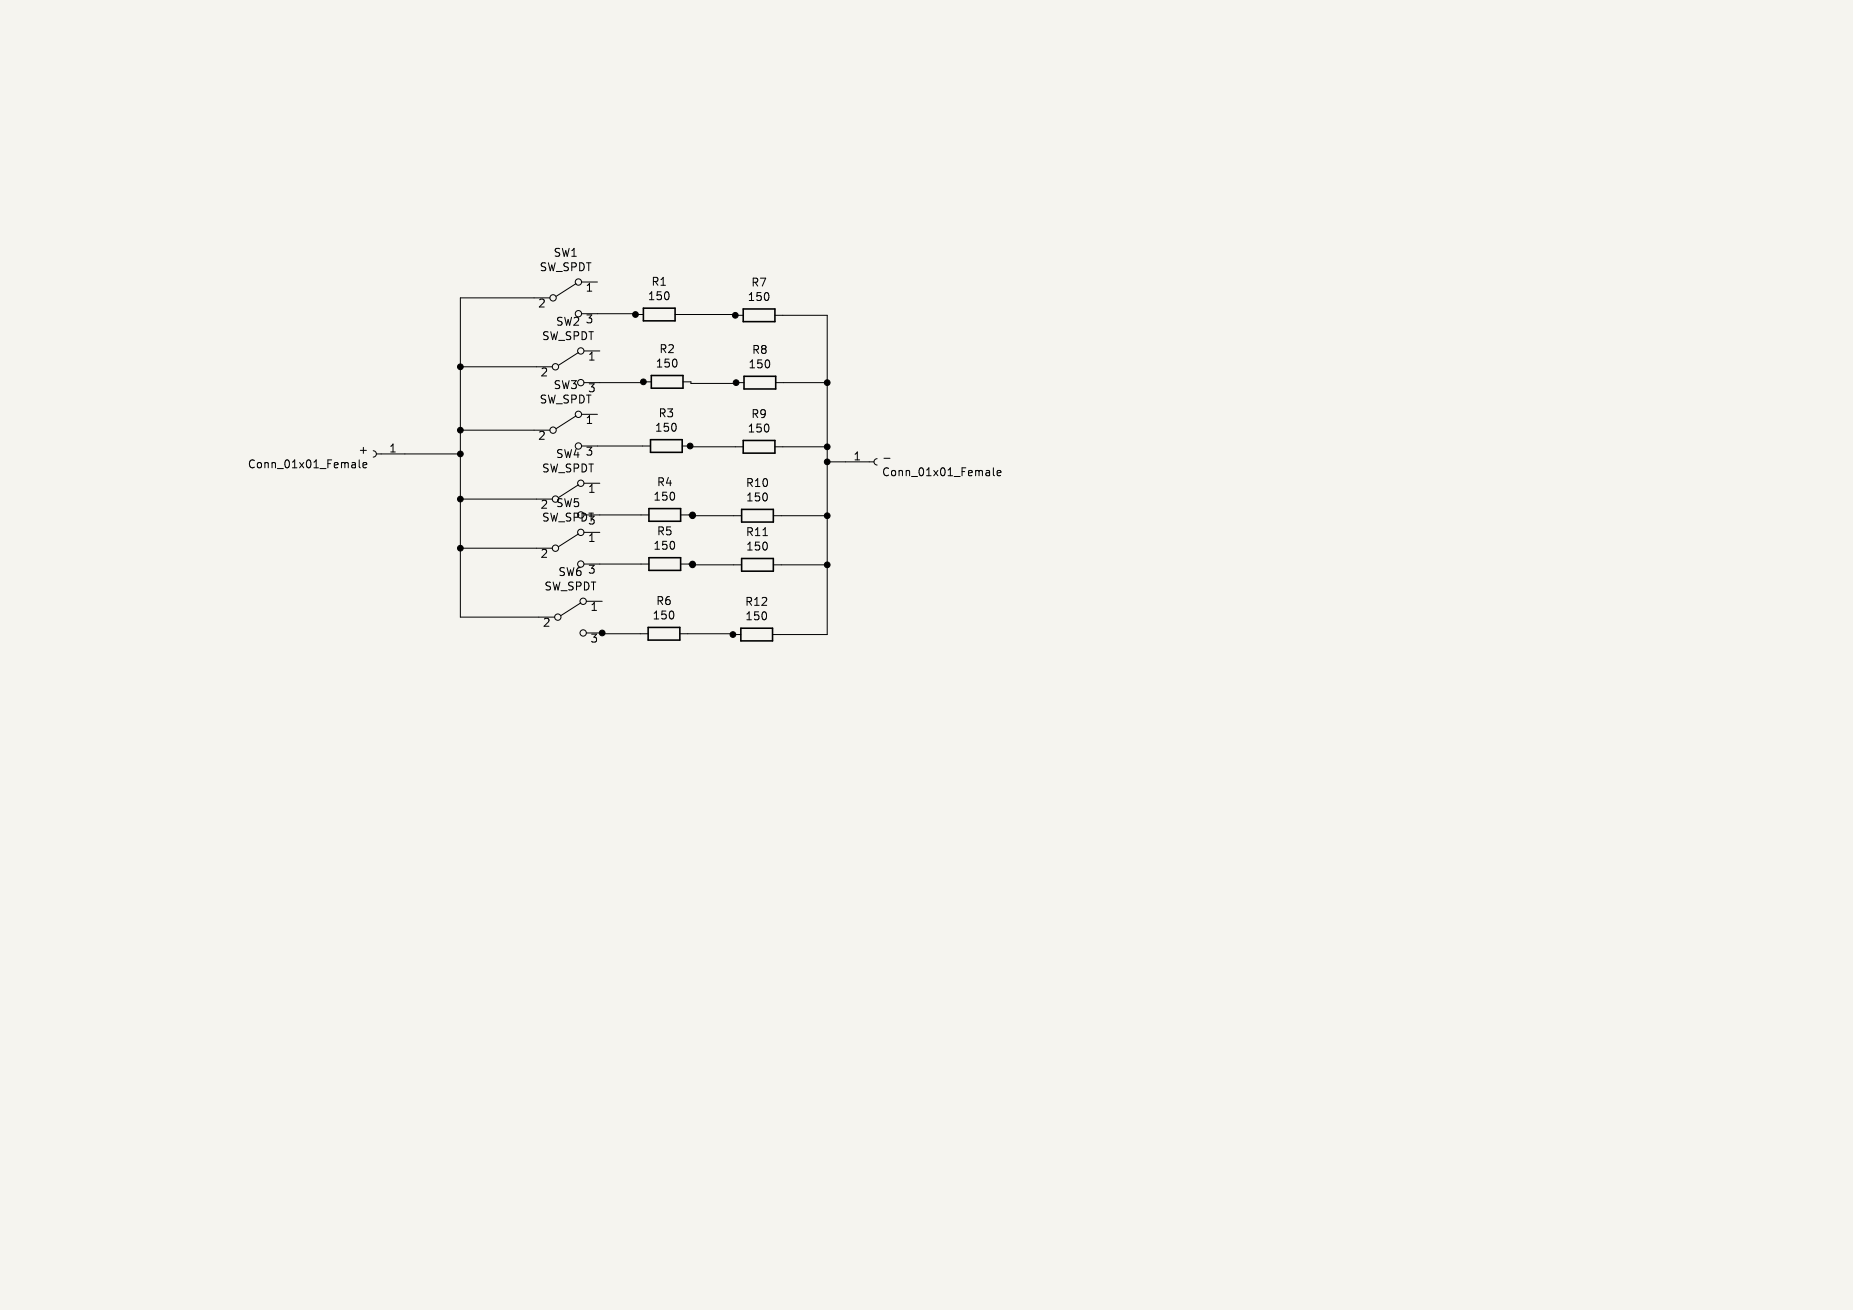
[picture p34: page 1]
