LEP-PEA-EPUSP/OpenSourcePowerElectronics-HW-LoadBoard-2026/Schematics and Layout/DC Load/Placa de resistores CC.kicad_pcb

## KiCad design Schematics and Layout/DC Load/Placa de resistores CC.kicad_pcb (2026-06-18)

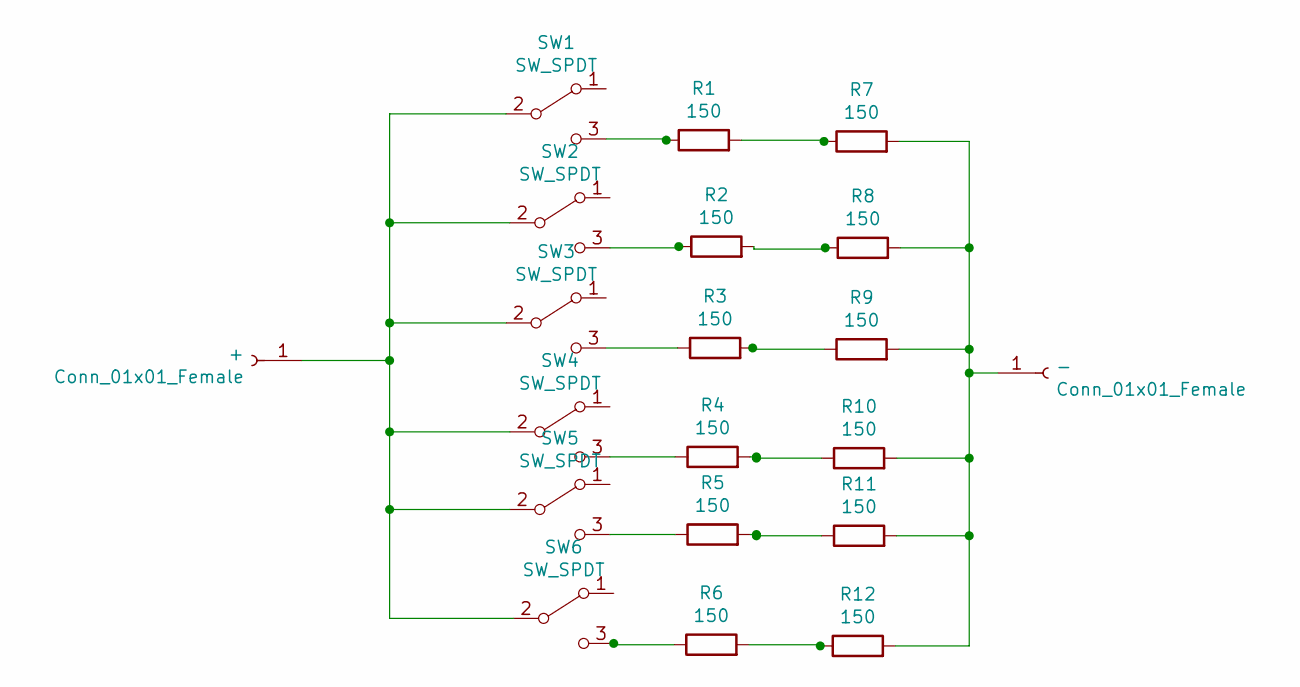
[picture p36: schematic Placa de resistores CC.kicad_sch]

Parts:
+: Conn_01x01_Female; Borne
-: Conn_01x01_Female; Borne
R1, R2, R3, R4, R5, R6, R7, R8, R9, R10, R11, R12: 150; Resistor_10W_porcelana
SW1, SW2, SW3, SW4, SW5, SW6: SW_SPDT; chave-hh

Connections:
unnamed: +.1, SW1.2 (B), SW2.2 (B), SW3.2 (B), SW4.2 (B), SW5.2 (B), SW6.2 (B)
unnamed: -.1, R7.2, R8.2, R9.2, R10.2, R11.2, R12.2
unnamed: R1.1, SW1.3 (C)
unnamed: R1.2, R7.1
unnamed: R2.1, SW2.3 (C)
unnamed: R2.2, R8.1
unnamed: R3.1, SW3.3 (C)
unnamed: R3.2, R9.1
unnamed: R4.1, SW4.3 (C)
unnamed: R5.1, SW5.3 (C)
unnamed: R6.1, SW6.3 (C)
unnamed: R4.2, R10.1
unnamed: R5.2, R11.1
unnamed: R6.2, R12.1

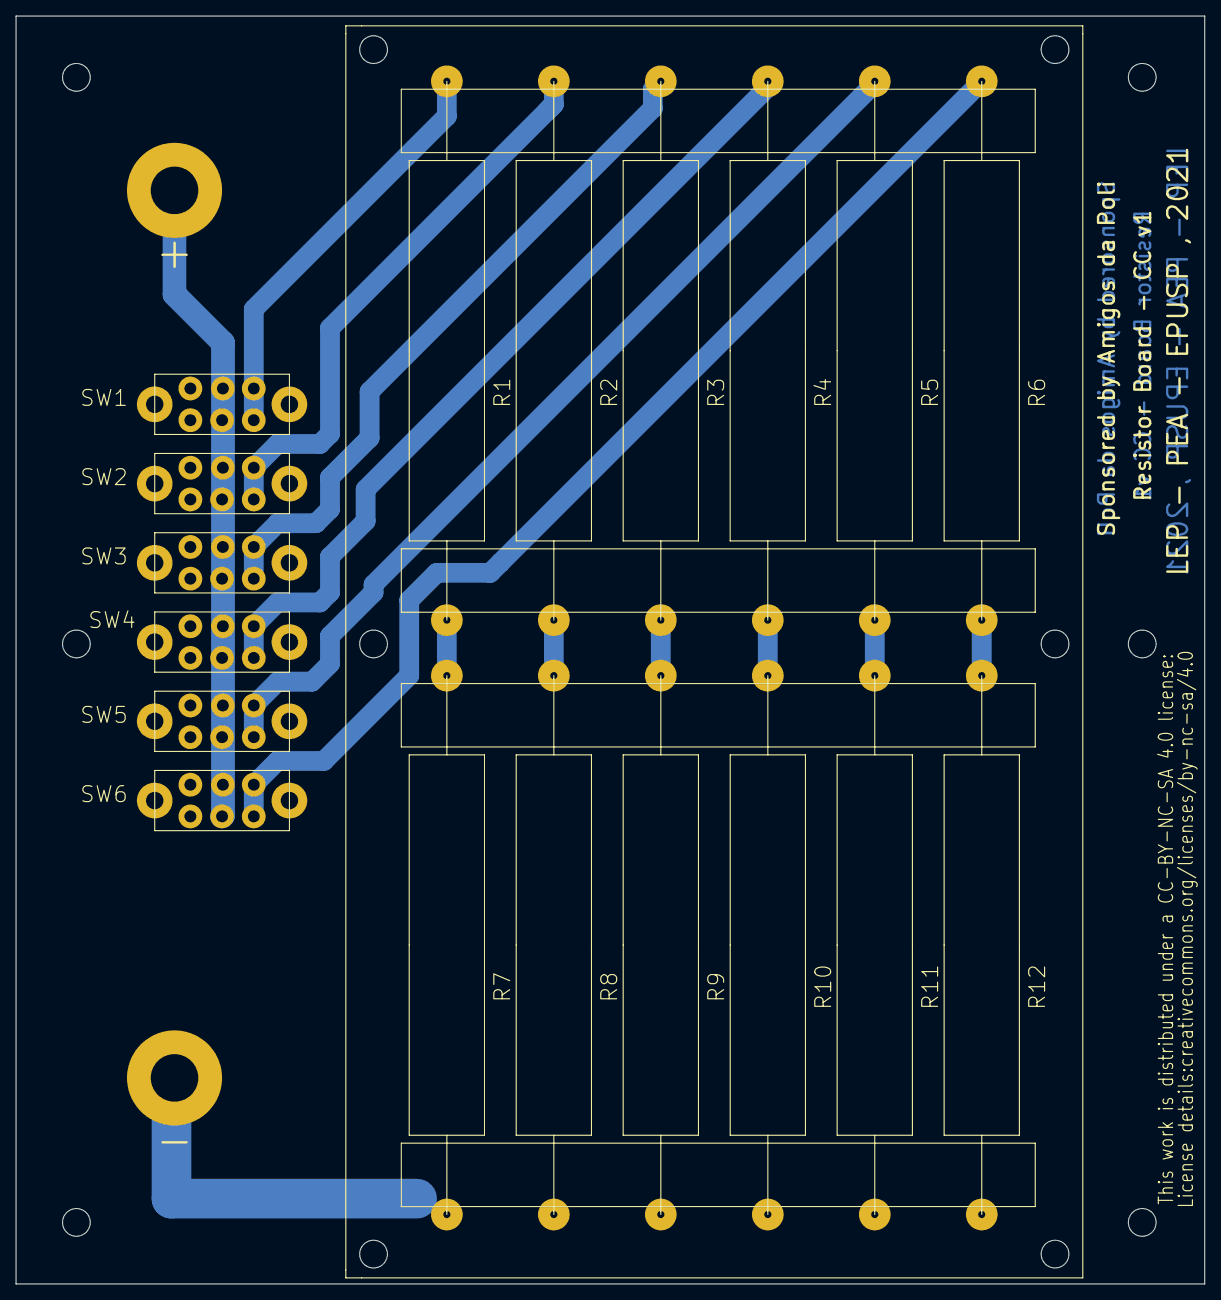
[picture p37: board Placa de resistores CC.kicad_pcb from above]

Board: 2 copper layers, 150.0 x 160.0 mm, 20 parts (0 on the bottom side), 14 nets.
