LEP-PEA-EPUSP/OpenSourcePowerElectronics-HW-LoadBoard-2026/Schematics and Layout/AC Load/Placa de resistores CA.kicad_pcb

## KiCad design Schematics and Layout/AC Load/Placa de resistores CA.kicad_pcb (2026-06-18)

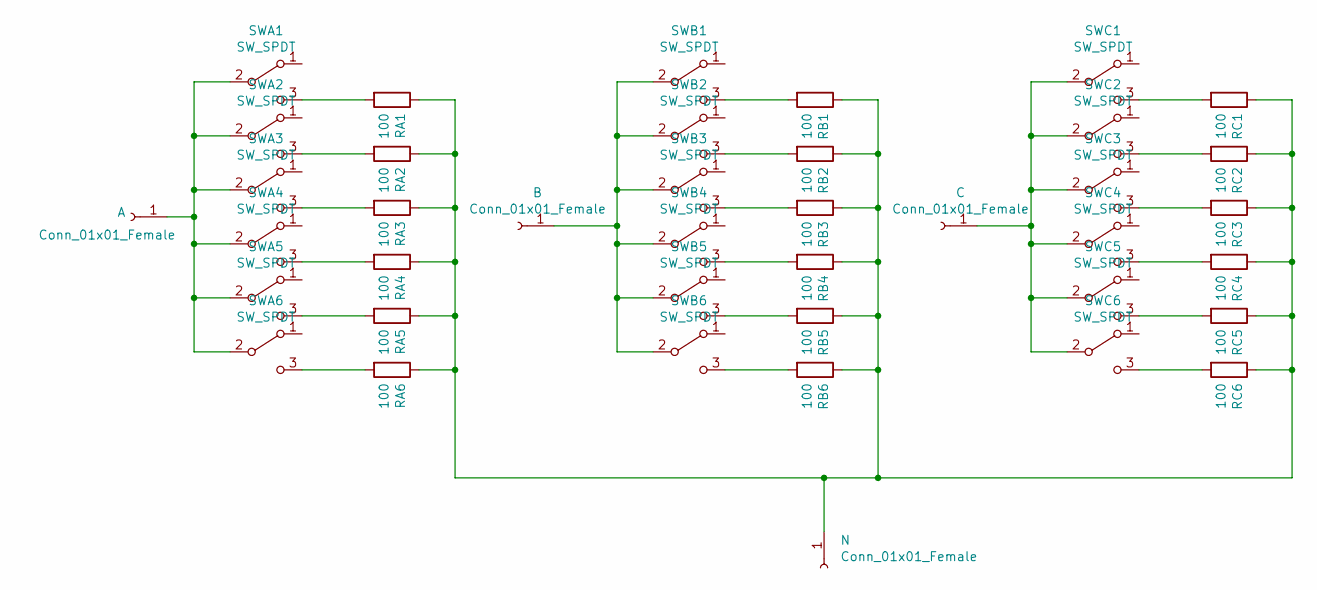
[picture p38: schematic Placa de resistores CA.kicad_sch]

Parts:
A: Conn_01x01_Female; Borne
B: Conn_01x01_Female; Borne
C: Conn_01x01_Female; Borne
N: Conn_01x01_Female; Borne
RA1, RA2, RA3, RA4, RA5, RA6: 100; Resistor_10W_porcelana
RB1, RB2, RB3, RB4, RB5, RB6: 100; Resistor_10W_porcelana
RC1, RC2, RC3, RC4, RC5, RC6: 100; Resistor_10W_porcelana
SWA1, SWA2, SWA3, SWA4, SWA5, SWA6: SW_SPDT; chave-hh
SWB1, SWB2, SWB3, SWB4, SWB5, SWB6: SW_SPDT; chave-hh
SWC1, SWC2, SWC3, SWC4, SWC5, SWC6: SW_SPDT; chave-hh

Connections:
unnamed: A.1, SWA1.2 (B), SWA2.2 (B), SWA3.2 (B), SWA4.2 (B), SWA5.2 (B), SWA6.2 (B)
unnamed: B.1, SWB1.2 (B), SWB2.2 (B), SWB3.2 (B), SWB4.2 (B), SWB5.2 (B), SWB6.2 (B)
unnamed: C.1, SWC1.2 (B), SWC2.2 (B), SWC3.2 (B), SWC4.2 (B), SWC5.2 (B), SWC6.2 (B)
unnamed: N.1, RA1.1, RA2.1, RA3.1, RA4.1, RA5.1, RA6.1, RB1.1, RB2.1, RB3.1, RB4.1, RB5.1, RB6.1, RC1.1, RC2.1, RC3.1, RC4.1, RC5.1, RC6.1
unnamed: RA1.2, SWA1.3 (C)
unnamed: RA2.2, SWA2.3 (C)
unnamed: RA3.2, SWA3.3 (C)
unnamed: RA4.2, SWA4.3 (C)
unnamed: RA5.2, SWA5.3 (C)
unnamed: RA6.2, SWA6.3 (C)
unnamed: RB1.2, SWB1.3 (C)
unnamed: RB2.2, SWB2.3 (C)
unnamed: RB3.2, SWB3.3 (C)
unnamed: RB4.2, SWB4.3 (C)
unnamed: RB5.2, SWB5.3 (C)
unnamed: RB6.2, SWB6.3 (C)
unnamed: RC1.2, SWC1.3 (C)
unnamed: RC2.2, SWC2.3 (C)
unnamed: RC3.2, SWC3.3 (C)
unnamed: RC4.2, SWC4.3 (C)
unnamed: RC5.2, SWC5.3 (C)
unnamed: RC6.2, SWC6.3 (C)

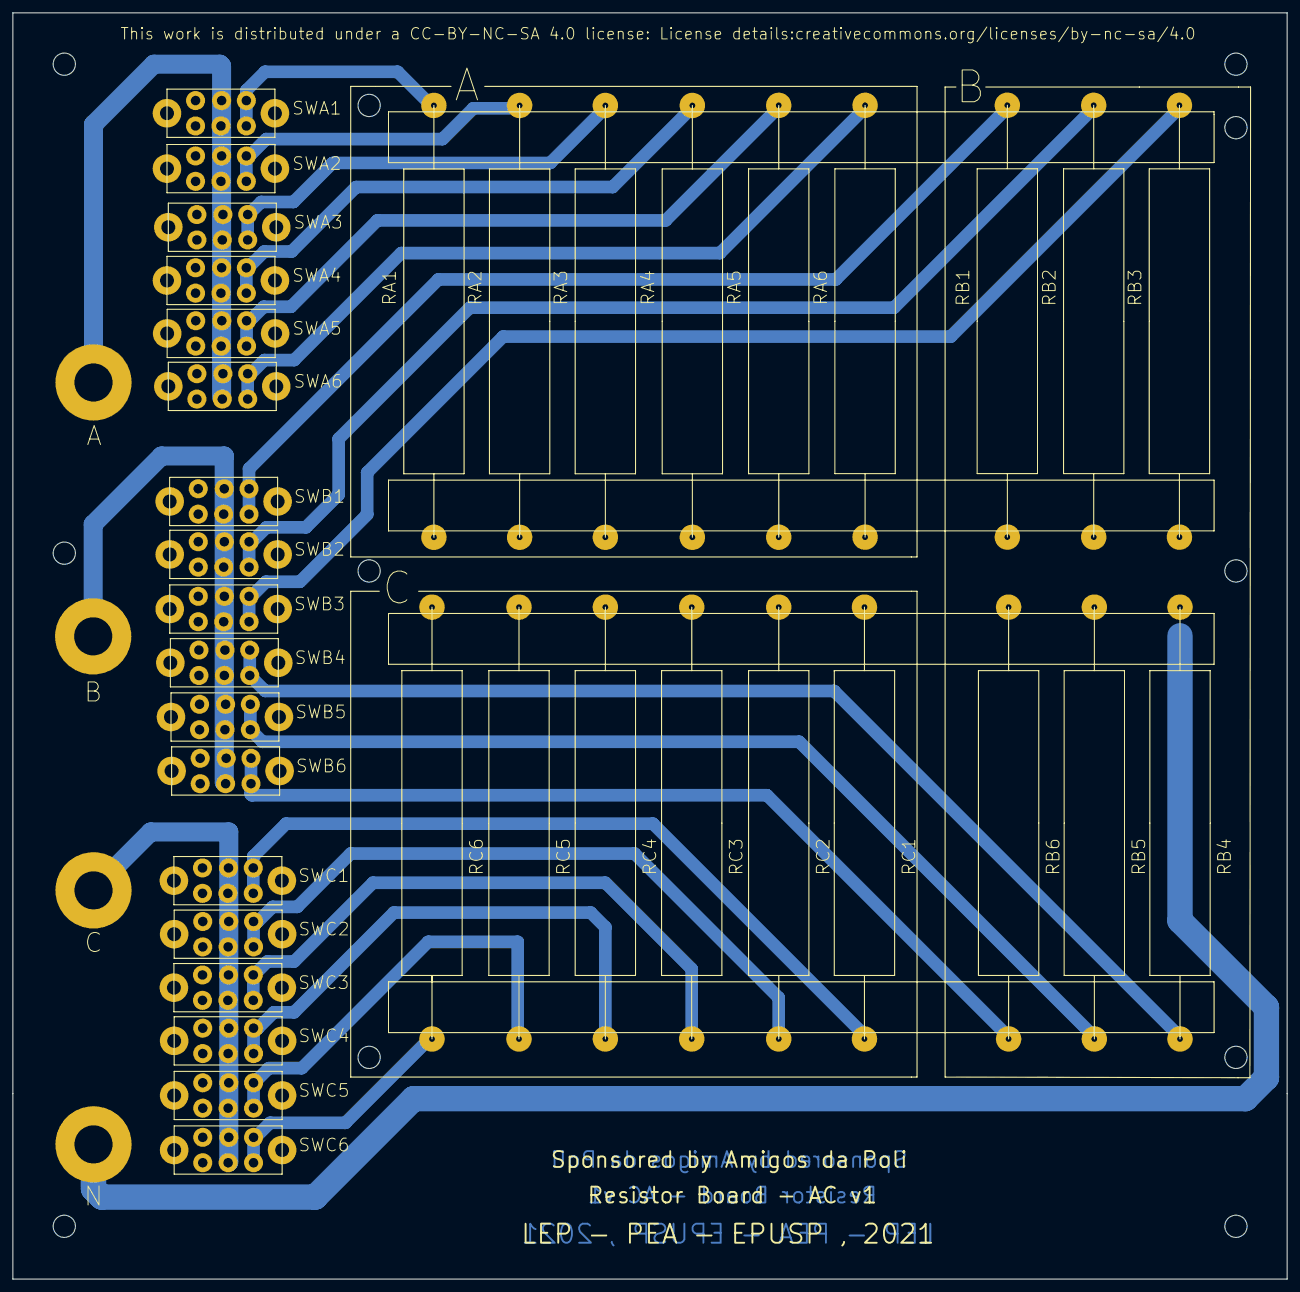
[picture p39: board Placa de resistores CA.kicad_pcb from above]

Board: 2 copper layers, 200.7 x 199.4 mm, 40 parts (0 on the bottom side), 22 nets.
