LEP-PEA-EPUSP/OpenSourcePowerElectronics-HW-LoadBoard-2026/(notices)

Notices in the files:
Schematics and Layout/AC Load/Placa de resistores CA.kicad_pcb:
This work is distributed under a CC-BY-NC-SA 4.0 license: License details:creativecommons.org/licenses/by-nc-sa/4.0
